ibanez-diego/proyecto-mecatronica-ibanez/Media/fotos/12.jpg

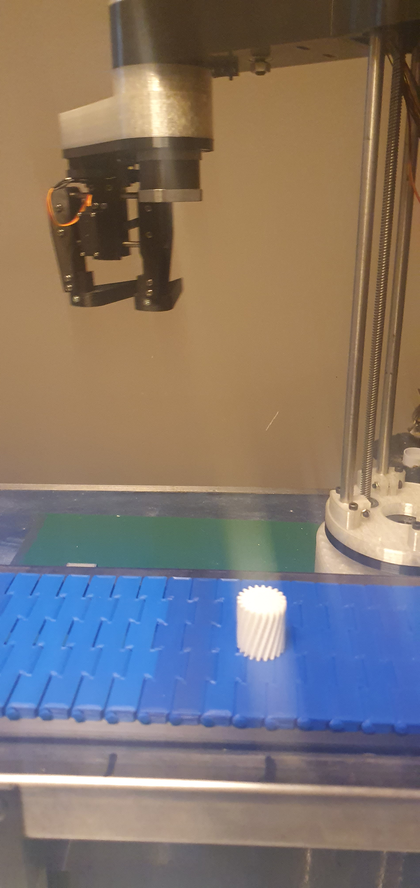
Media/fotos/12.jpg
