ibanez-diego/proyecto-mecatronica-ibanez/Media/fotos/4.jpg

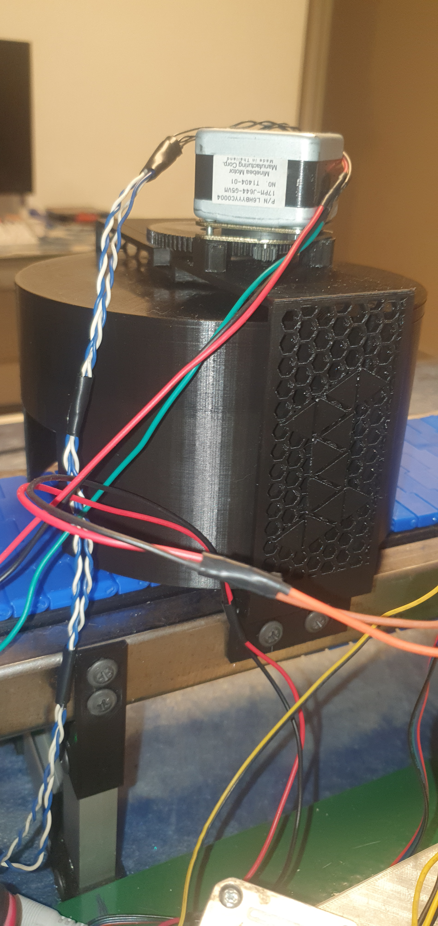
Media/fotos/4.jpg
