ibanez-diego/proyecto-mecatronica-ibanez/Documentacion/Diagrama_Conexion.png

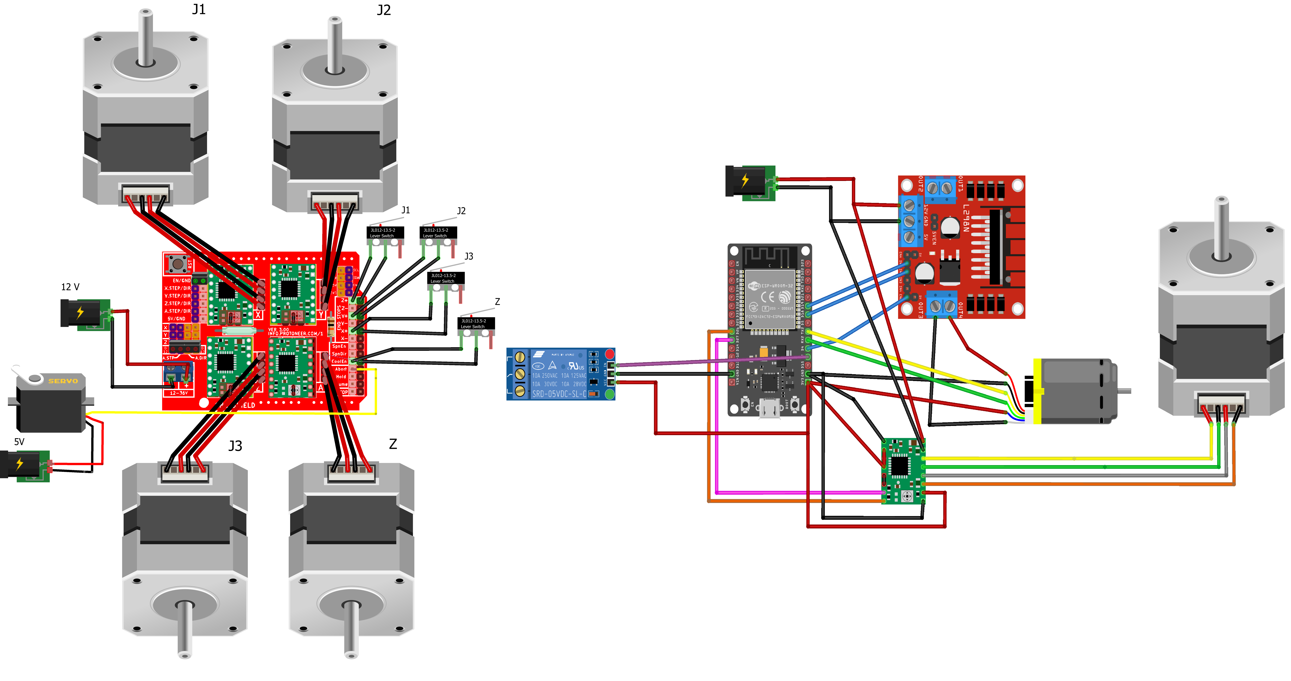
Documentacion/Diagrama_Conexion.png
