ibanez-diego/proyecto-mecatronica-ibanez/Documentacion/Diagrama_Flujo.png

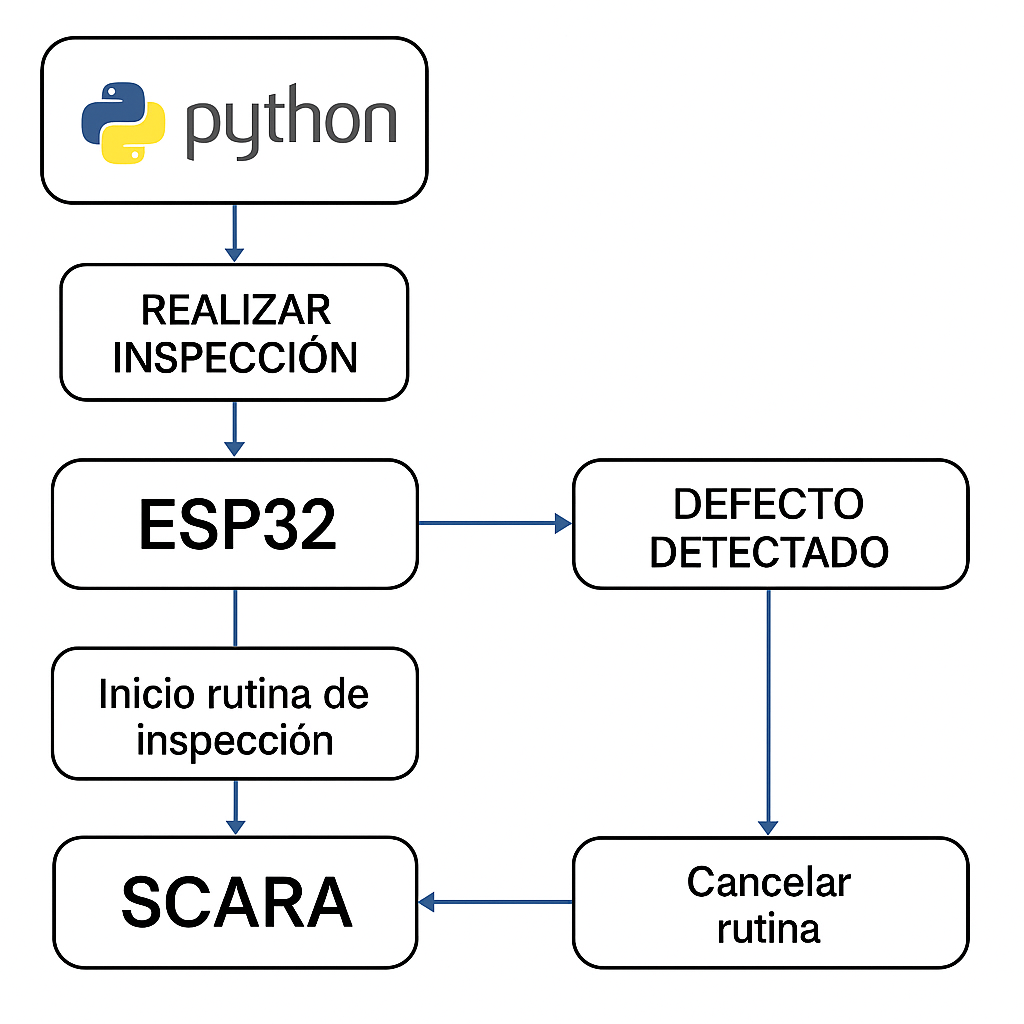
Documentacion/Diagrama_Flujo.png
