ibanez-diego/proyecto-mecatronica-ibanez/Media/fotos/1.jpg

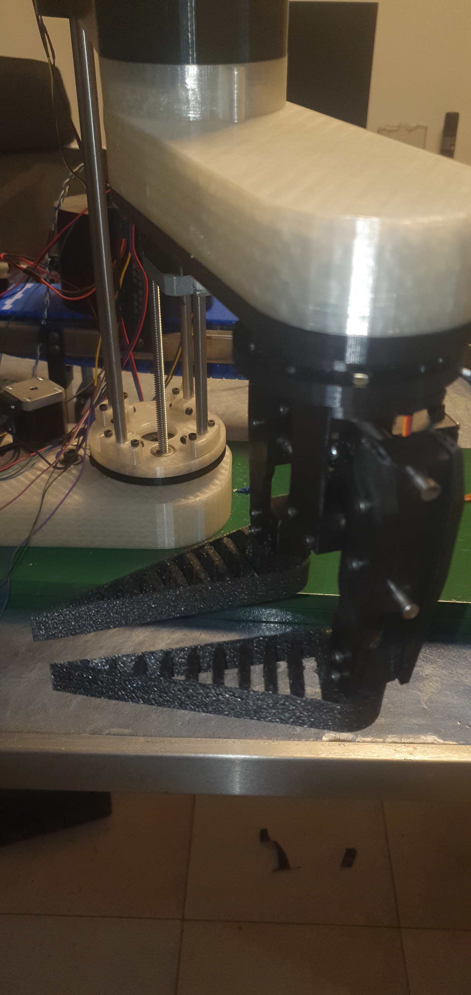
Media/fotos/1.jpg
