ibanez-diego/proyecto-mecatronica-ibanez/Media/fotos/2.jpg

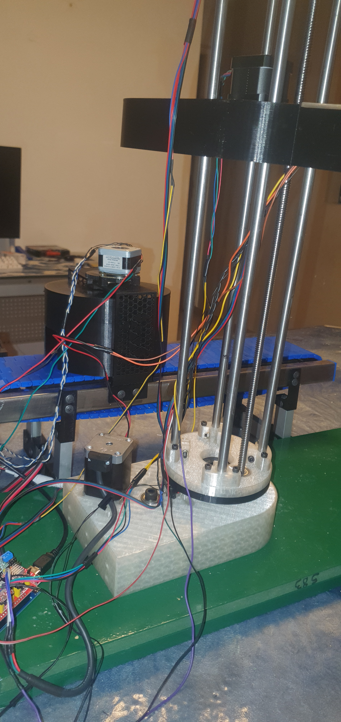
Media/fotos/2.jpg
