ibanez-diego/proyecto-mecatronica-ibanez/Media/fotos/3.jpg

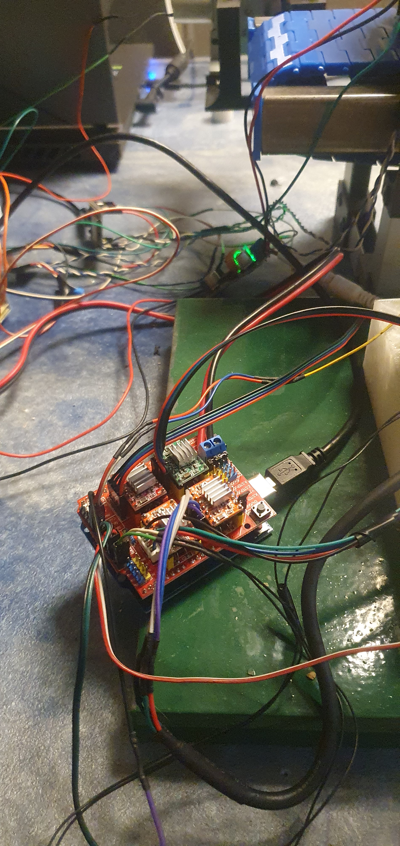
Media/fotos/3.jpg
