ibanez-diego/proyecto-mecatronica-ibanez/Media/fotos/5.jpg

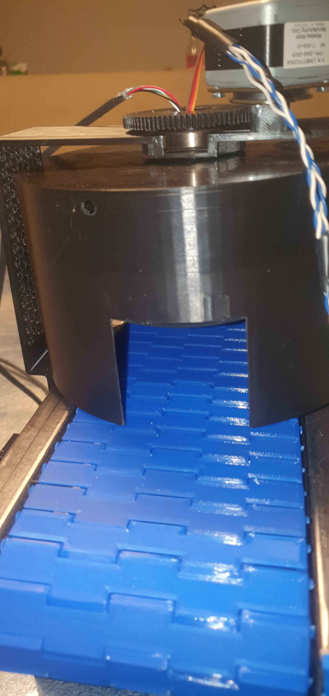
Media/fotos/5.jpg
