ibanez-diego/proyecto-mecatronica-ibanez/Media/fotos/6.jpg

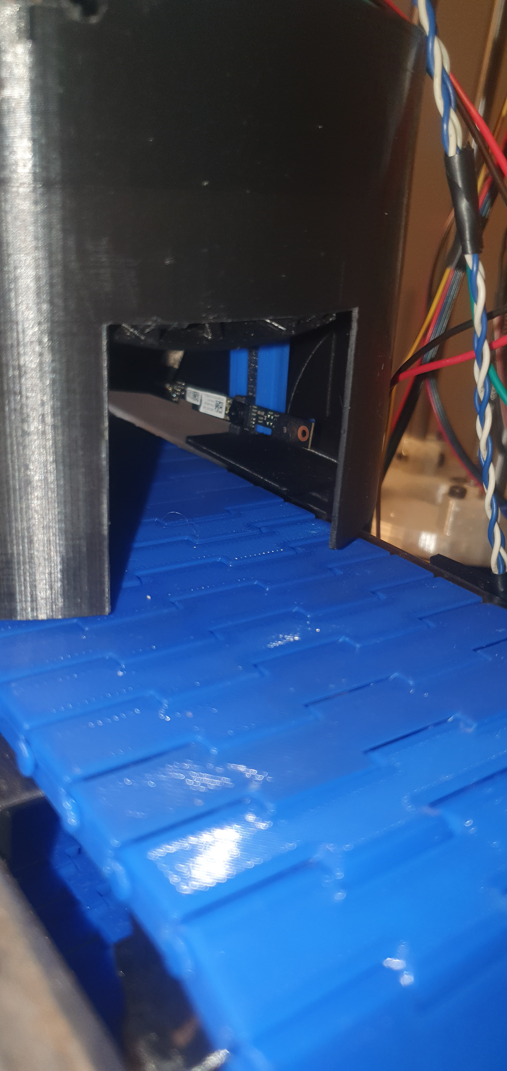
Media/fotos/6.jpg
