ibanez-diego/proyecto-mecatronica-ibanez/Media/fotos/7.jpg

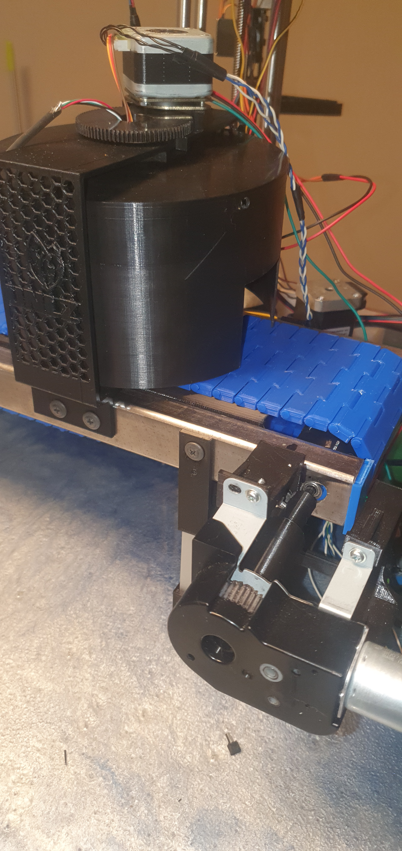
Media/fotos/7.jpg
