ibanez-diego/proyecto-mecatronica-ibanez/Media/fotos/8.jpg

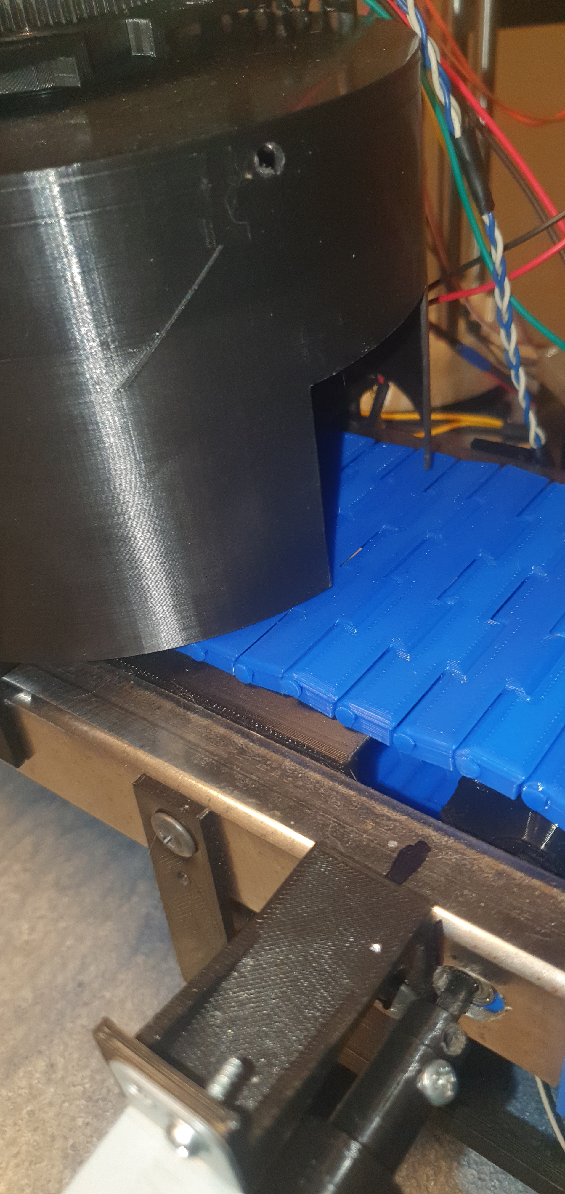
Media/fotos/8.jpg
