ibanez-diego/proyecto-mecatronica-ibanez/Media/fotos/9.jpg

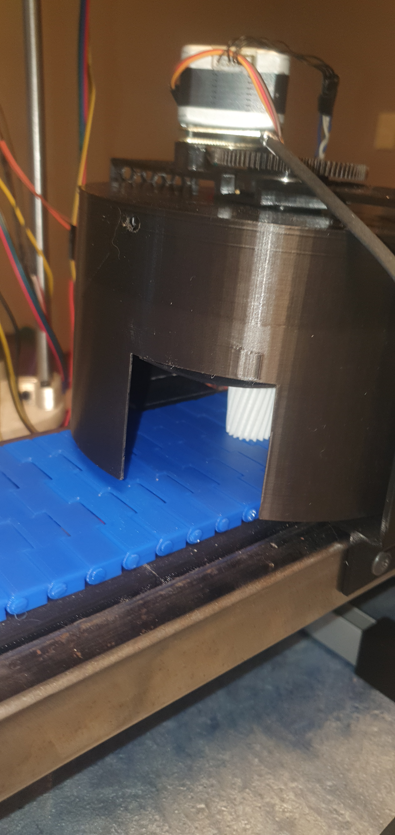
Media/fotos/9.jpg
