ibanez-diego/proyecto-mecatronica-ibanez/Media/fotos/10.jpg

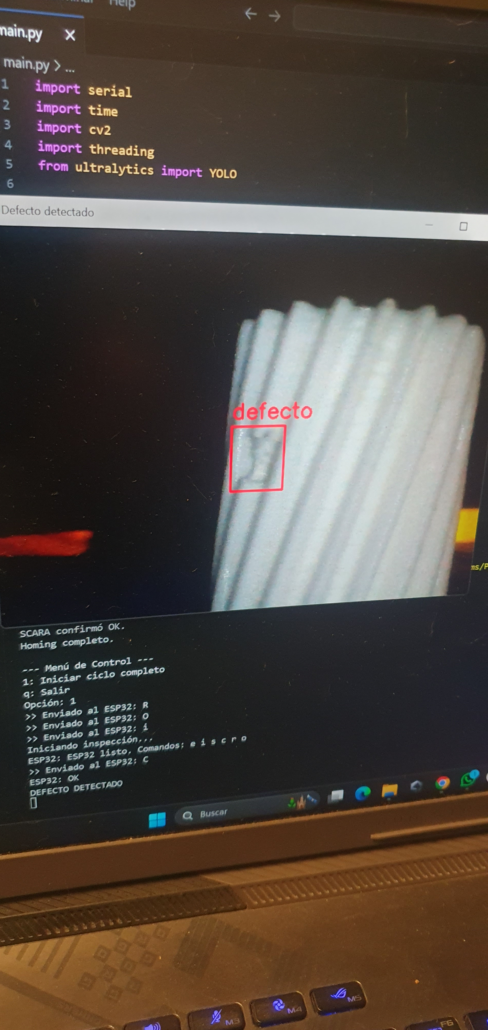
Media/fotos/10.jpg
