ibanez-diego/proyecto-mecatronica-ibanez/Media/fotos/11.jpg

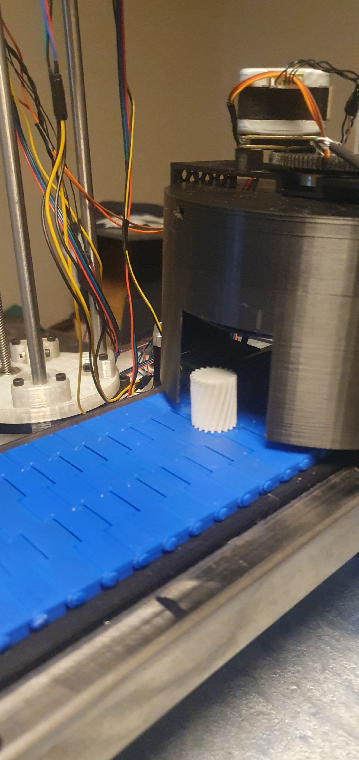
Media/fotos/11.jpg
