ibanez-diego/proyecto-mecatronica-ibanez/Media/fotos/13.jpg

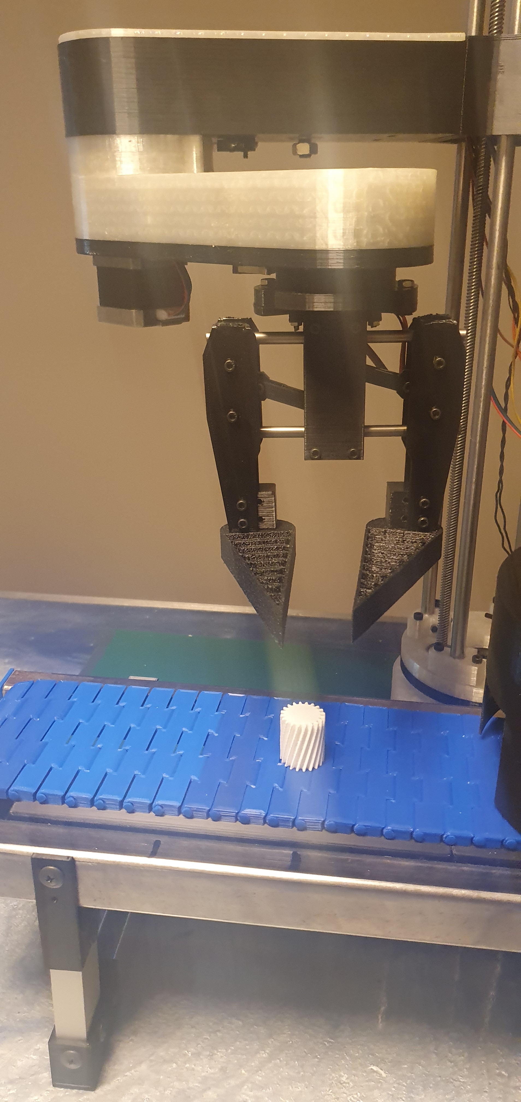
Media/fotos/13.jpg
