ibanez-diego/proyecto-mecatronica-ibanez/Media/fotos/14.jpg

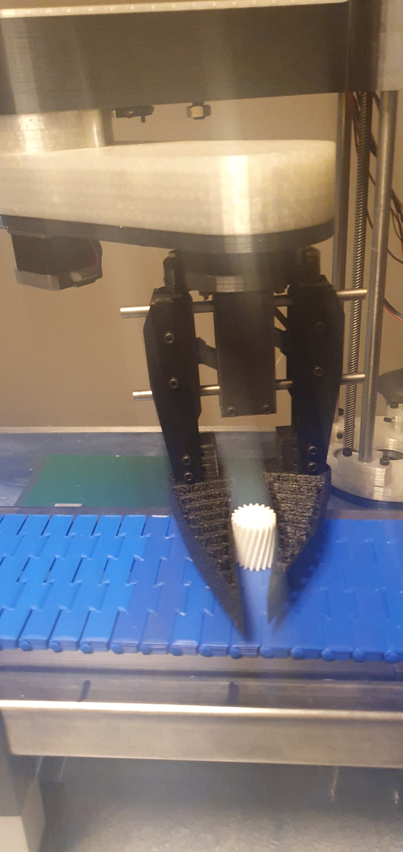
Media/fotos/14.jpg
