ibanez-diego/proyecto-mecatronica-ibanez/Media/fotos/15.jpg

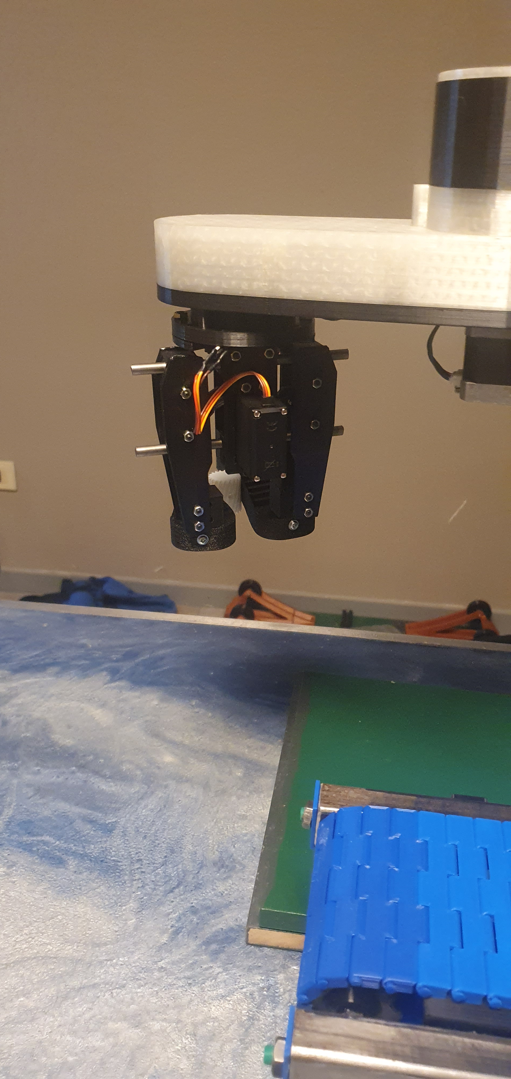
Media/fotos/15.jpg
