ibanez-diego/proyecto-mecatronica-ibanez/Documentacion/planos mecanicos/gripper.pdf

148.5 ¹²⁷.57 | 162.86 127.59 | Ø3.2 | Ø6 | Ø6.2 Ø4.1 | Ø3.6 | Ø1 5. Ø53 Ø12.5 | Ø30 Ø35 | Ø6 R3.6 | R3.1R3 R2R16
R3 | R28.5 R39 | R4.55 | R3.1 R3

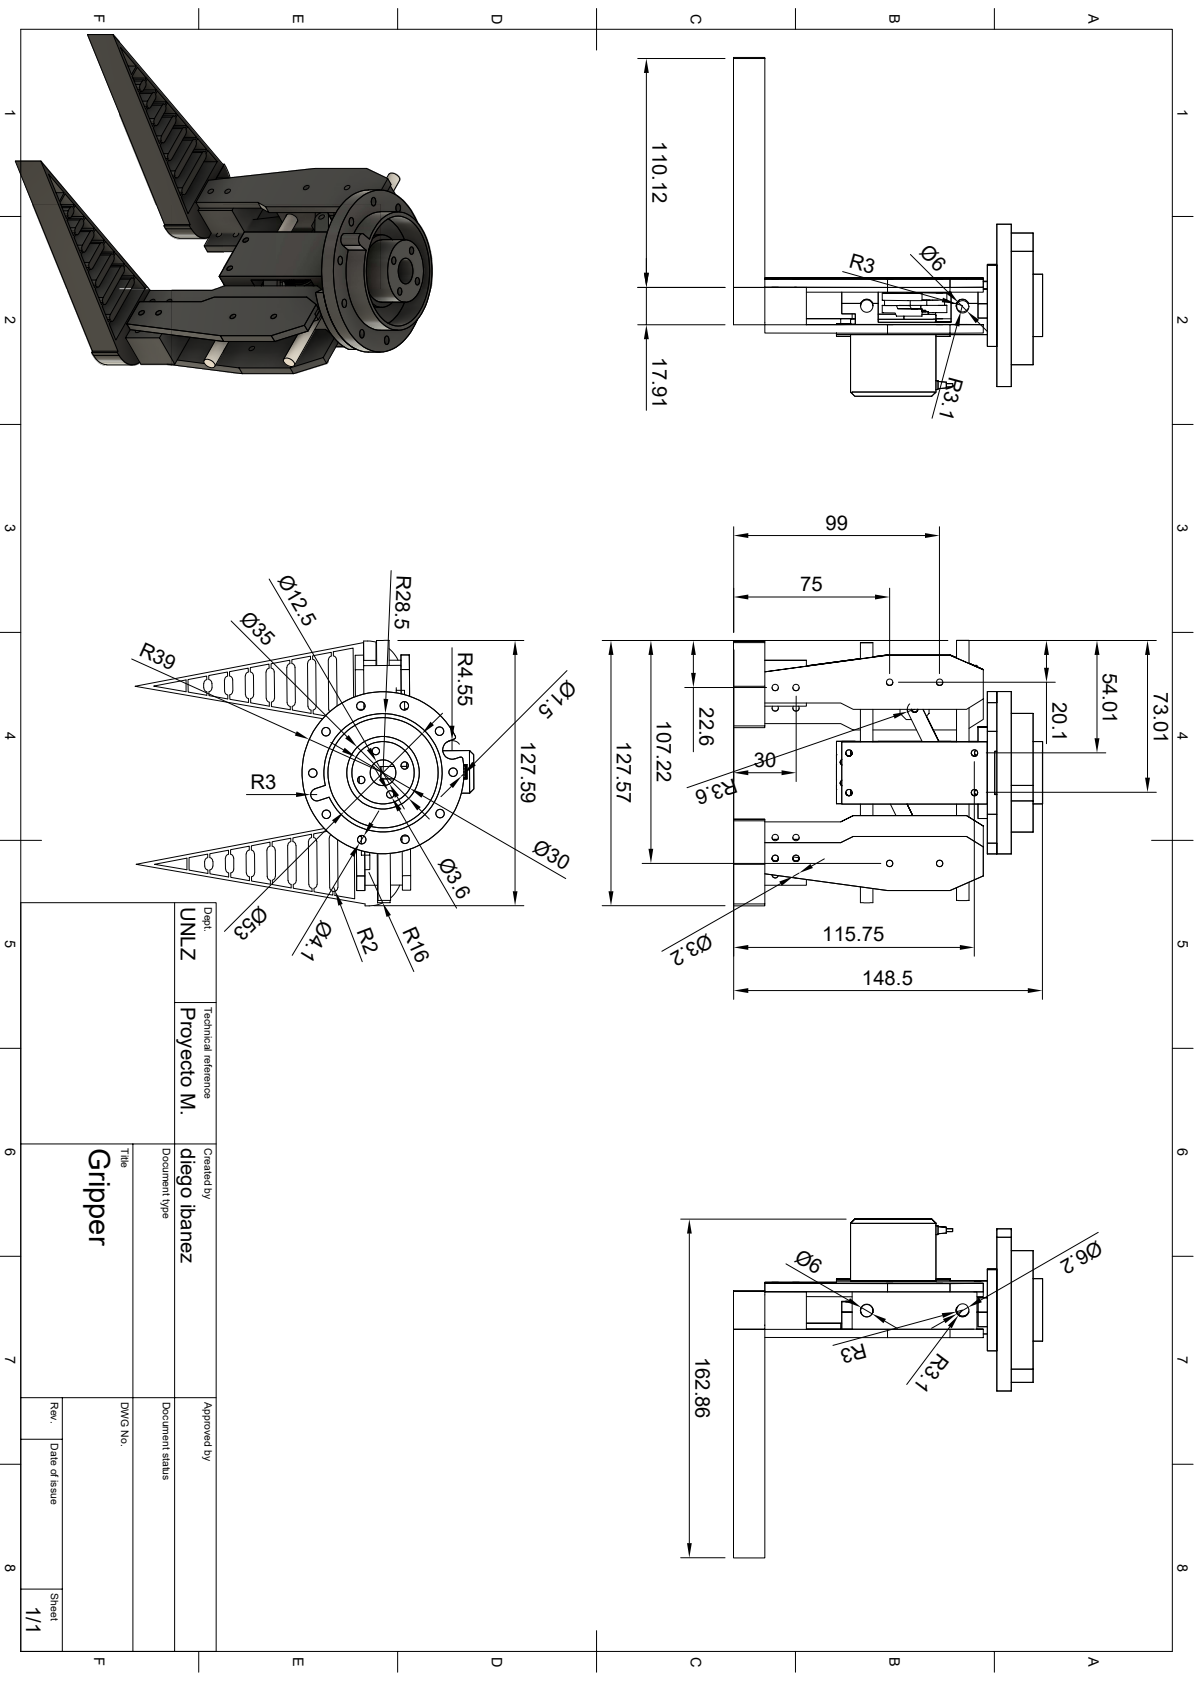
[picture p26: page 1]
115.75 ¹⁰⁷.22

1 A 2 3 4 5 6 7 8 1 2 3 4 5 6 7 8 FEDCB FEDCBA Dept. Technical reference Created by Approved by Title DWG No. Document type Document status Rev. Date of issue Sheet 1/1 Gripper diego ibanez Proyecto M. UNLZ
