ibanez-diego/proyecto-mecatronica-ibanez/Documentacion/planos mecanicos/guia_camara_soporte_servo.pdf

89.42 132.91 | 96.57
96.4 | Ø2.9 Ø5 Ø3 Ø7 Ø2.9 | R43.5 | R48.9 | R.56 R1 | R1.5 | R6.49 R5 R2.36 | R5.68 | R6.41

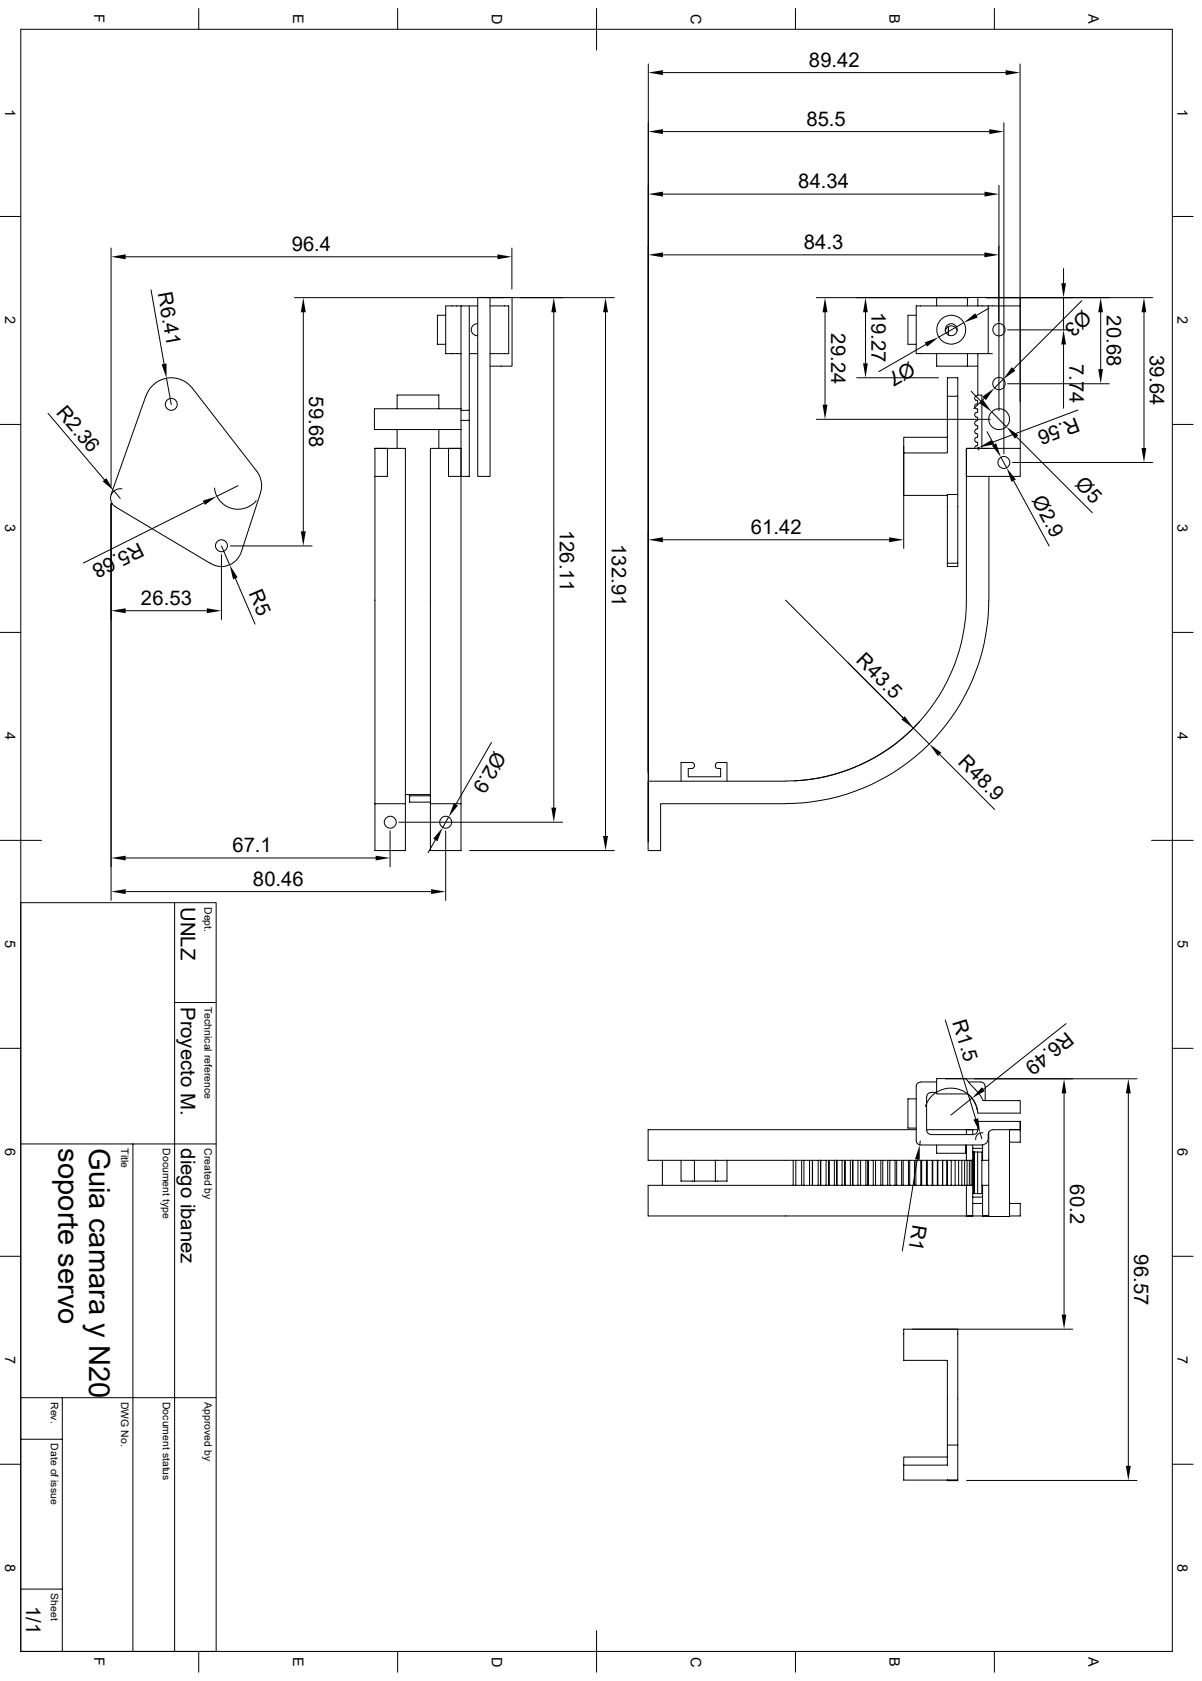
[picture p27: page 1]

1 A 2 3 4 5 6 7 8 1 2 3 4 5 6 7 8 FEDCB FEDCBA Dept. Technical reference Created by Approved by Title DWG No. Document type Document status Rev. Date of issue Sheet 1/1 soporte servo Guia camara y N20 diego ibanez Proyecto M. UNLZ
