ibanez-diego/proyecto-mecatronica-ibanez/Documentacion/planos mecanicos/J1.pdf

12.5 8

18 Ø9.95 Ø4.1Ø9.1 Ø15 Ø3.6 67.18 | 67.18

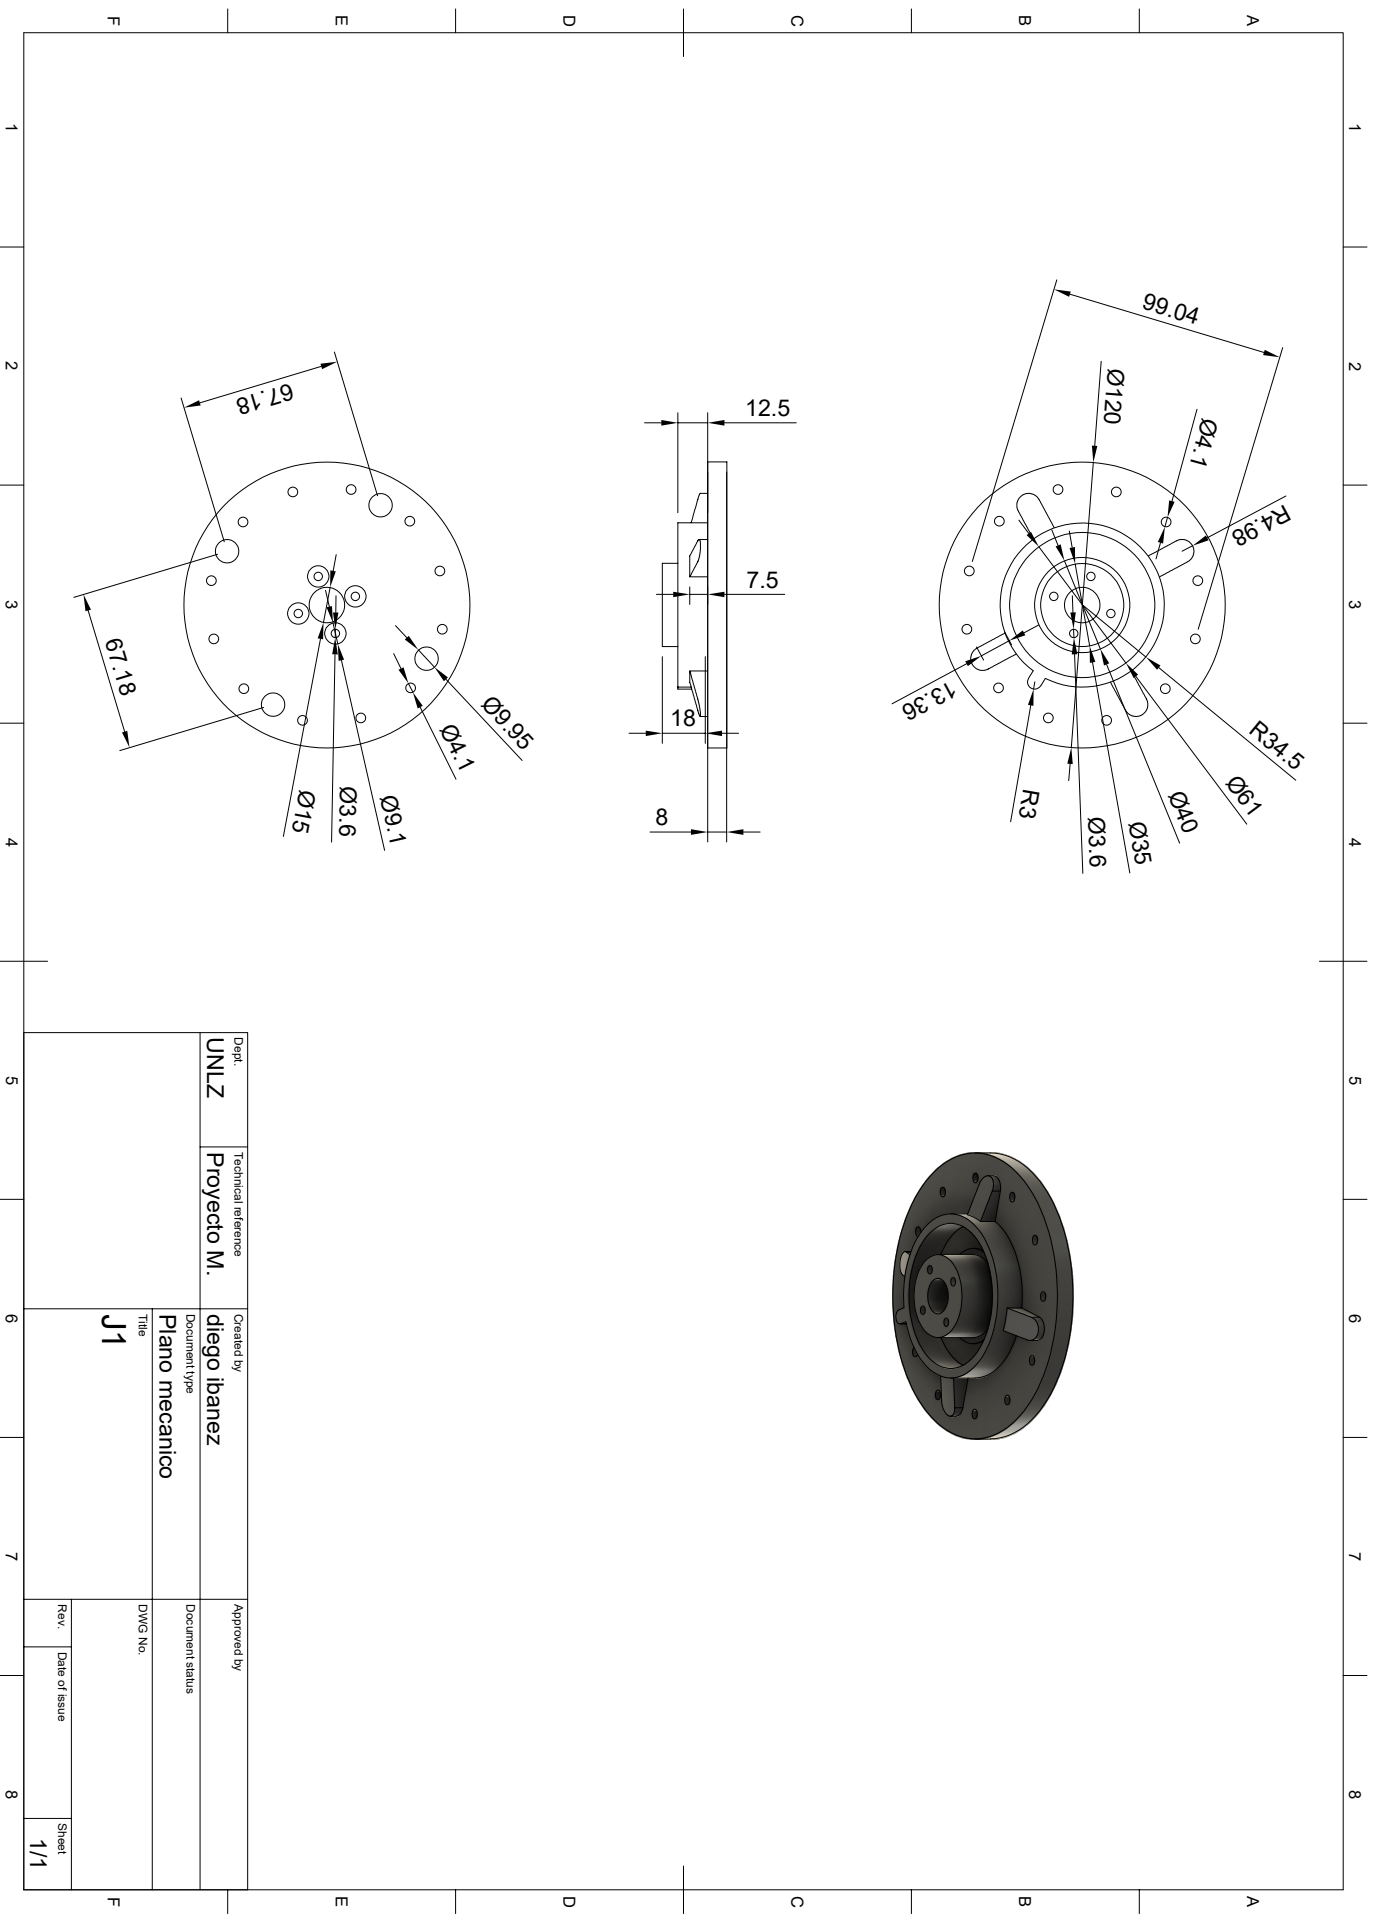
[picture p28: page 1]

1 A 2 3 4 5 6 7 8 1 2 3 4 5 6 7 8 FEDCB FEDCBA Dept. Technical reference Created by Approved by Title DWG No. Document type Document status Rev. Date of issue Sheet Plano mecanico 1/1 J1diego ibanez Proyecto M. UNLZ Ø4.1 R4.98 Ø120 R34.5 Ø61 Ø40 Ø3.6 Ø35 R3 99.04 13.36
