ibanez-diego/proyecto-mecatronica-ibanez/Documentacion/planos mecanicos/J2.pdf

18.5 Ø30 Ø53Ø35 R37 R39 | 4.16 ⁸.31 | Ø4.1

2.5

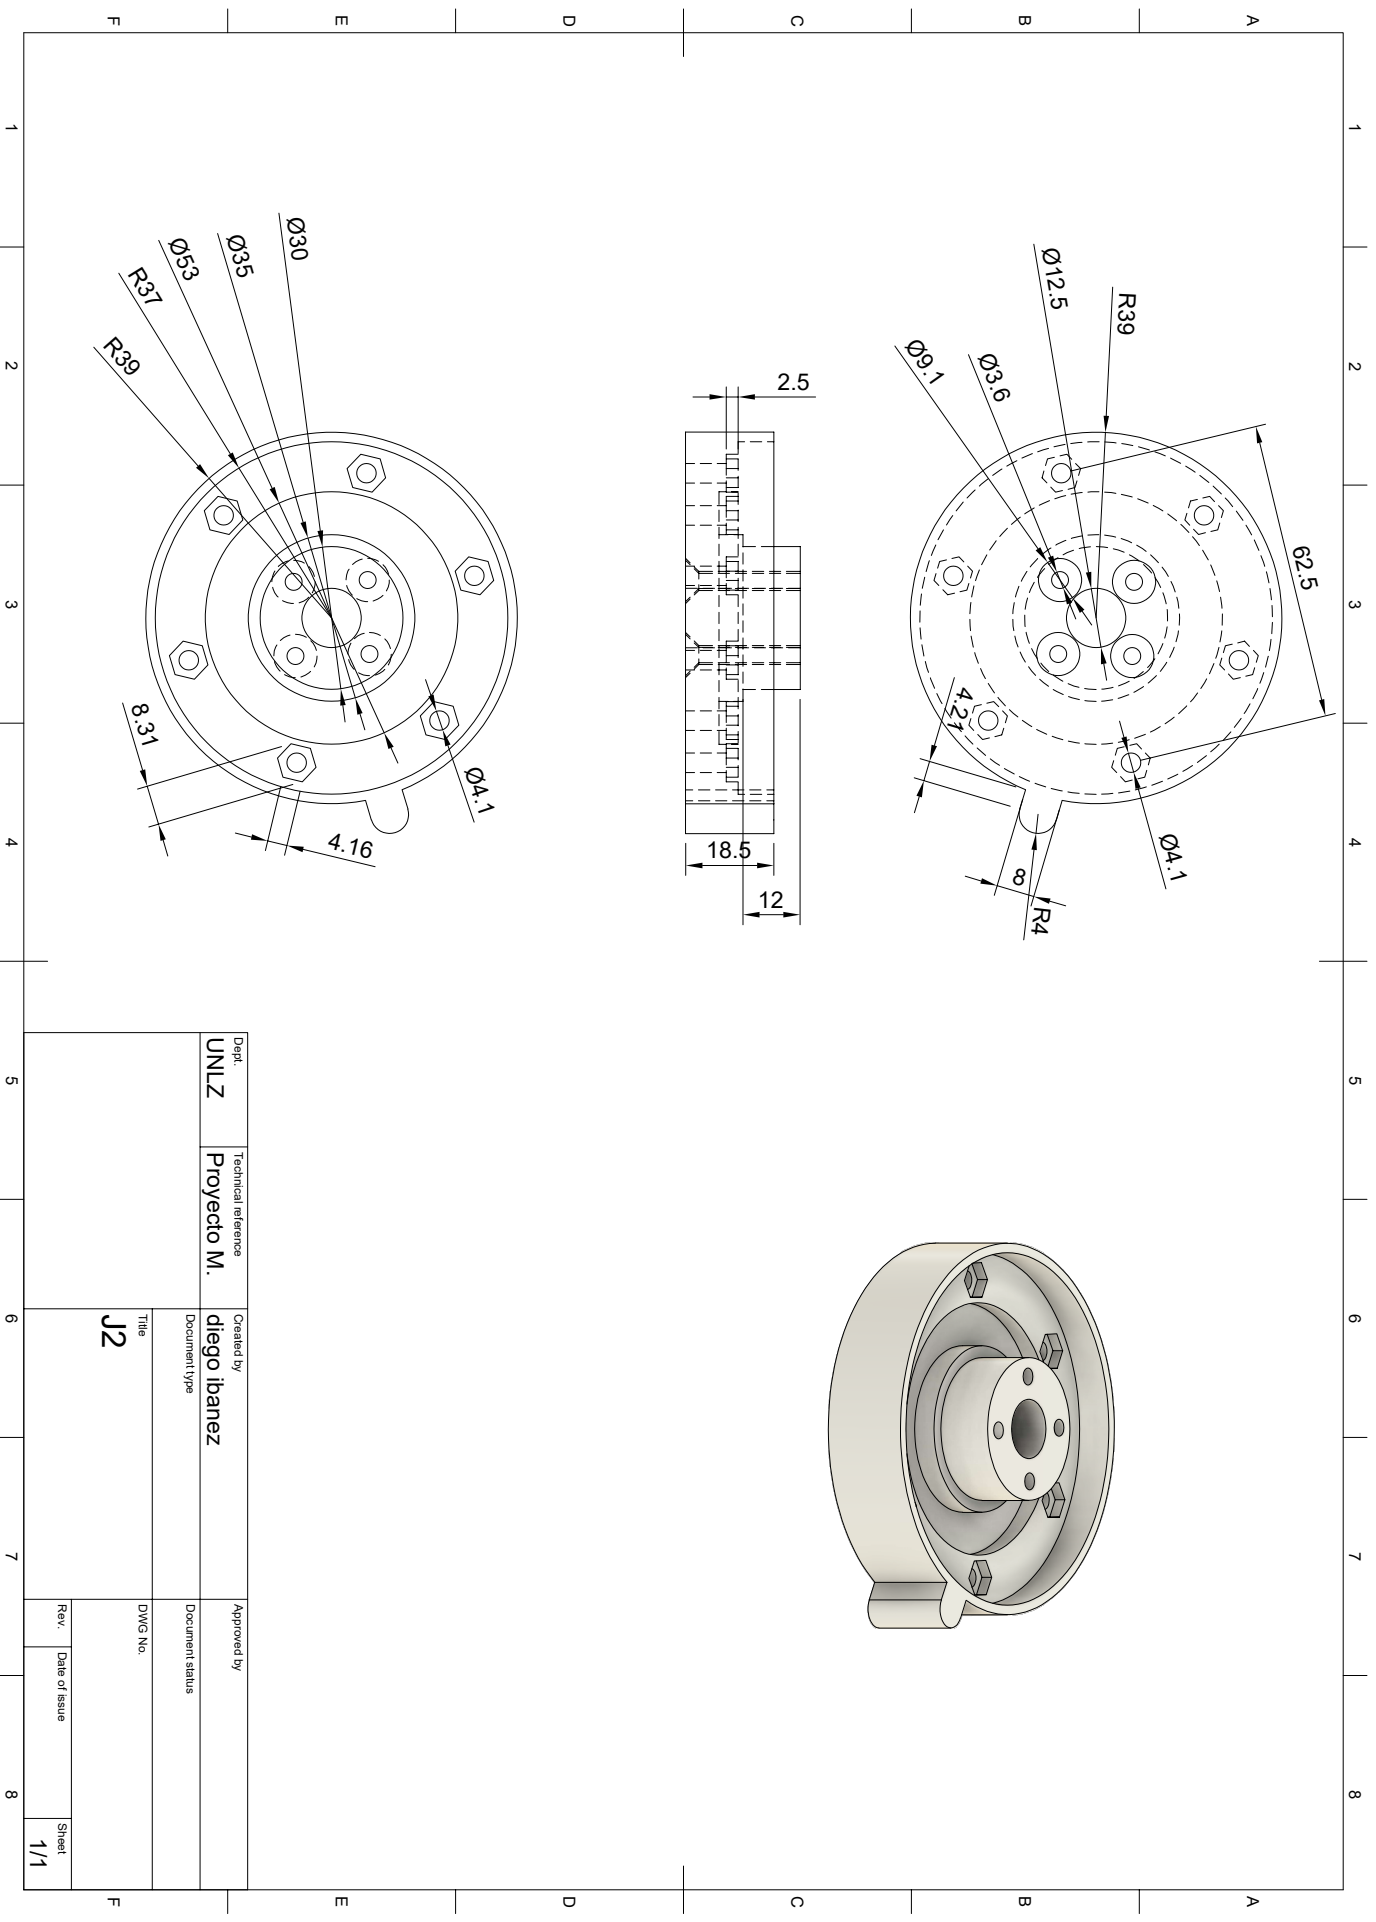
[picture p29: page 1]

1 A 2 3 4 5 6 7 8 1 2 3 4 5 6 7 8 FEDCB FEDCBA Dept. Technical reference Created by Approved by Title DWG No. Document type Document status Rev. Date of issue Sheet 1/1 J2diego ibanez Proyecto M. UNLZ Ø4.1R4 4.21 Ø9.1Ø3.6 62.5 R39 Ø12.5 8
