ibanez-diego/proyecto-mecatronica-ibanez/Documentacion/planos mecanicos/J3.pdf

10.5

14

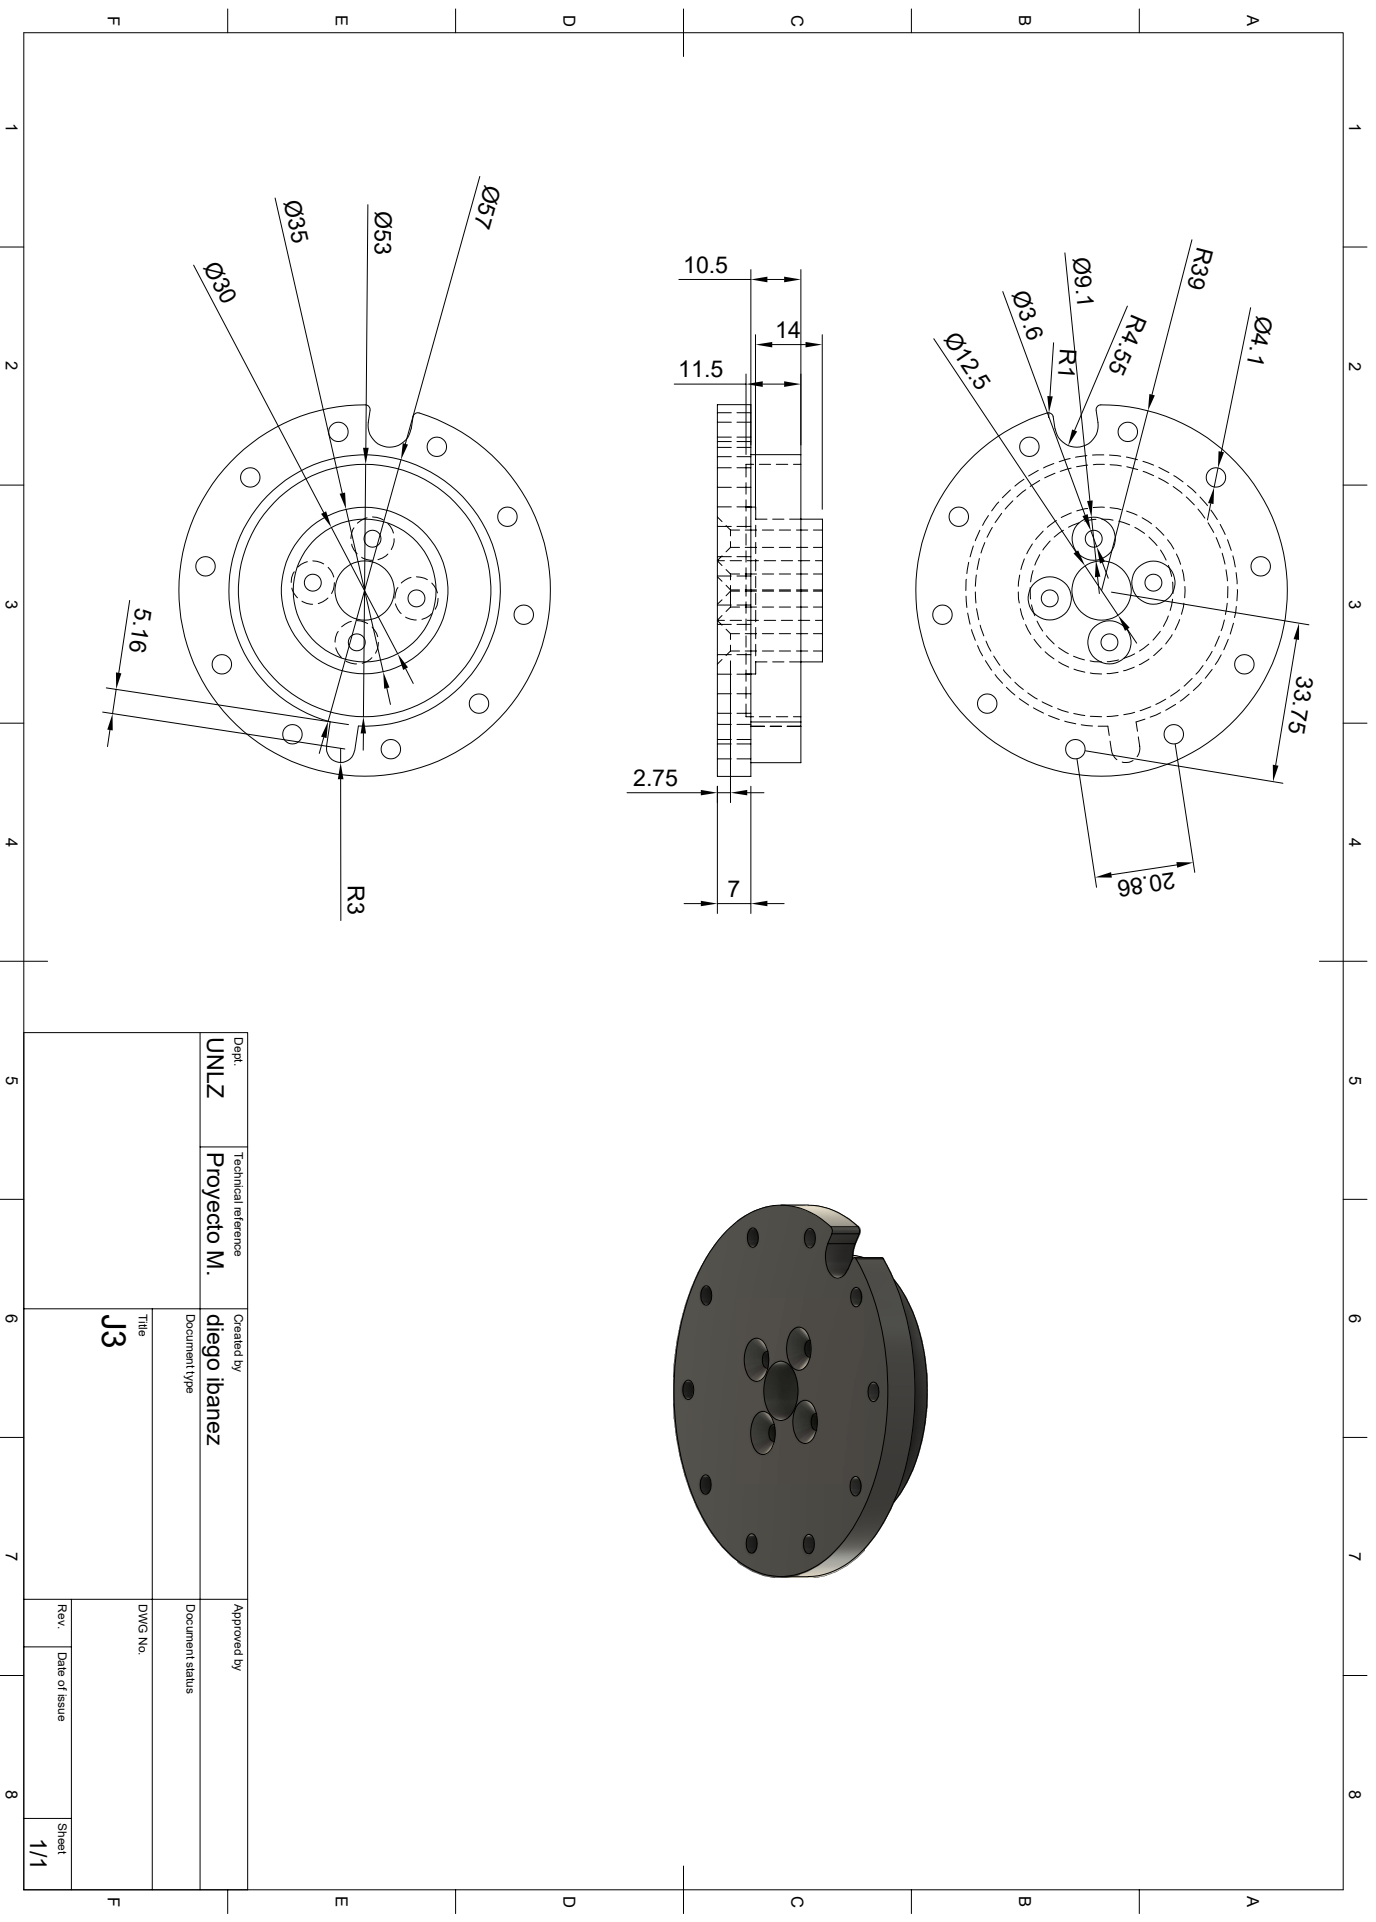
[picture p30: page 1]

1 A 2 3 4 5 6 7 8 1 2 3 4 5 6 7 8 FEDCB FEDCBA Dept. Technical reference Created by Approved by Title DWG No. Document type Document status Rev. Date of issue Sheet 1/1 J3diego ibanez Proyecto M. UNLZ R39 Ø4.1 Ø9.1Ø3.6 Ø12.5 R4.55R1 20.86 33.75
