ibanez-diego/proyecto-mecatronica-ibanez/Documentacion/planos mecanicos/Recductor_J1.pdf

72.49 | Ø3.6 Ø3.6 | Ø15 Ø71.92 Ø15 Ø35 Ø40 Ø62 | Ø8 Ø52.82 Ø15.9 Ø52.82Ø8 | Ø14.62R2.5 R2.5 67.77
42.61 39.44

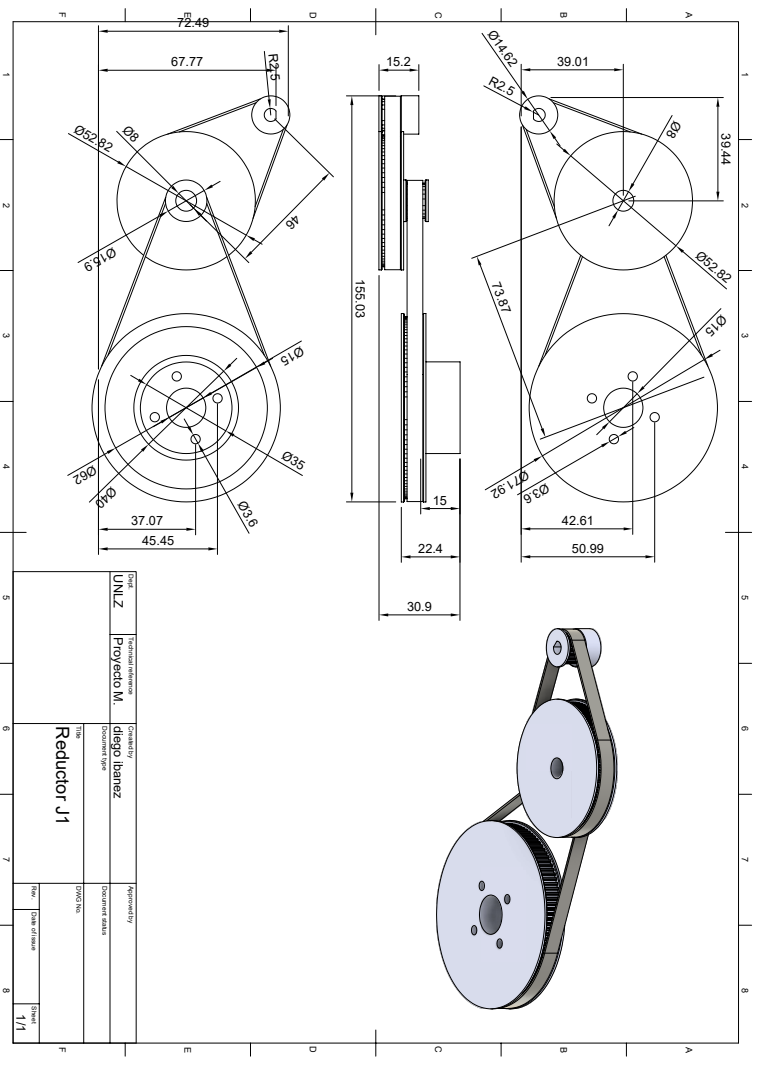
[picture p31: page 1]

1 A 2 3 4 5 6 7 8 1 2 3 4 5 6 7 8 FEDCB FEDCBA Dept. Technical reference Created by Approved by Title DWG No. Document type Document status Rev. Date of issue Sheet 1/1 Reductor J1 diego ibanez Proyecto M. UNLZ 155.03
