ibanez-diego/proyecto-mecatronica-ibanez/Documentacion/planos mecanicos/Recductor_J2.pdf

36.2 | 105.99 | Ø3 6. Ø3.6 | Ø12.5 | Ø30 Ø35 Ø53 Ø60.46Ø12.5 | Ø17.33 Ø8 Ø53.62 Ø8 | Ø14.62 R2.5 R2.5 146.76 90

42.57 25.88

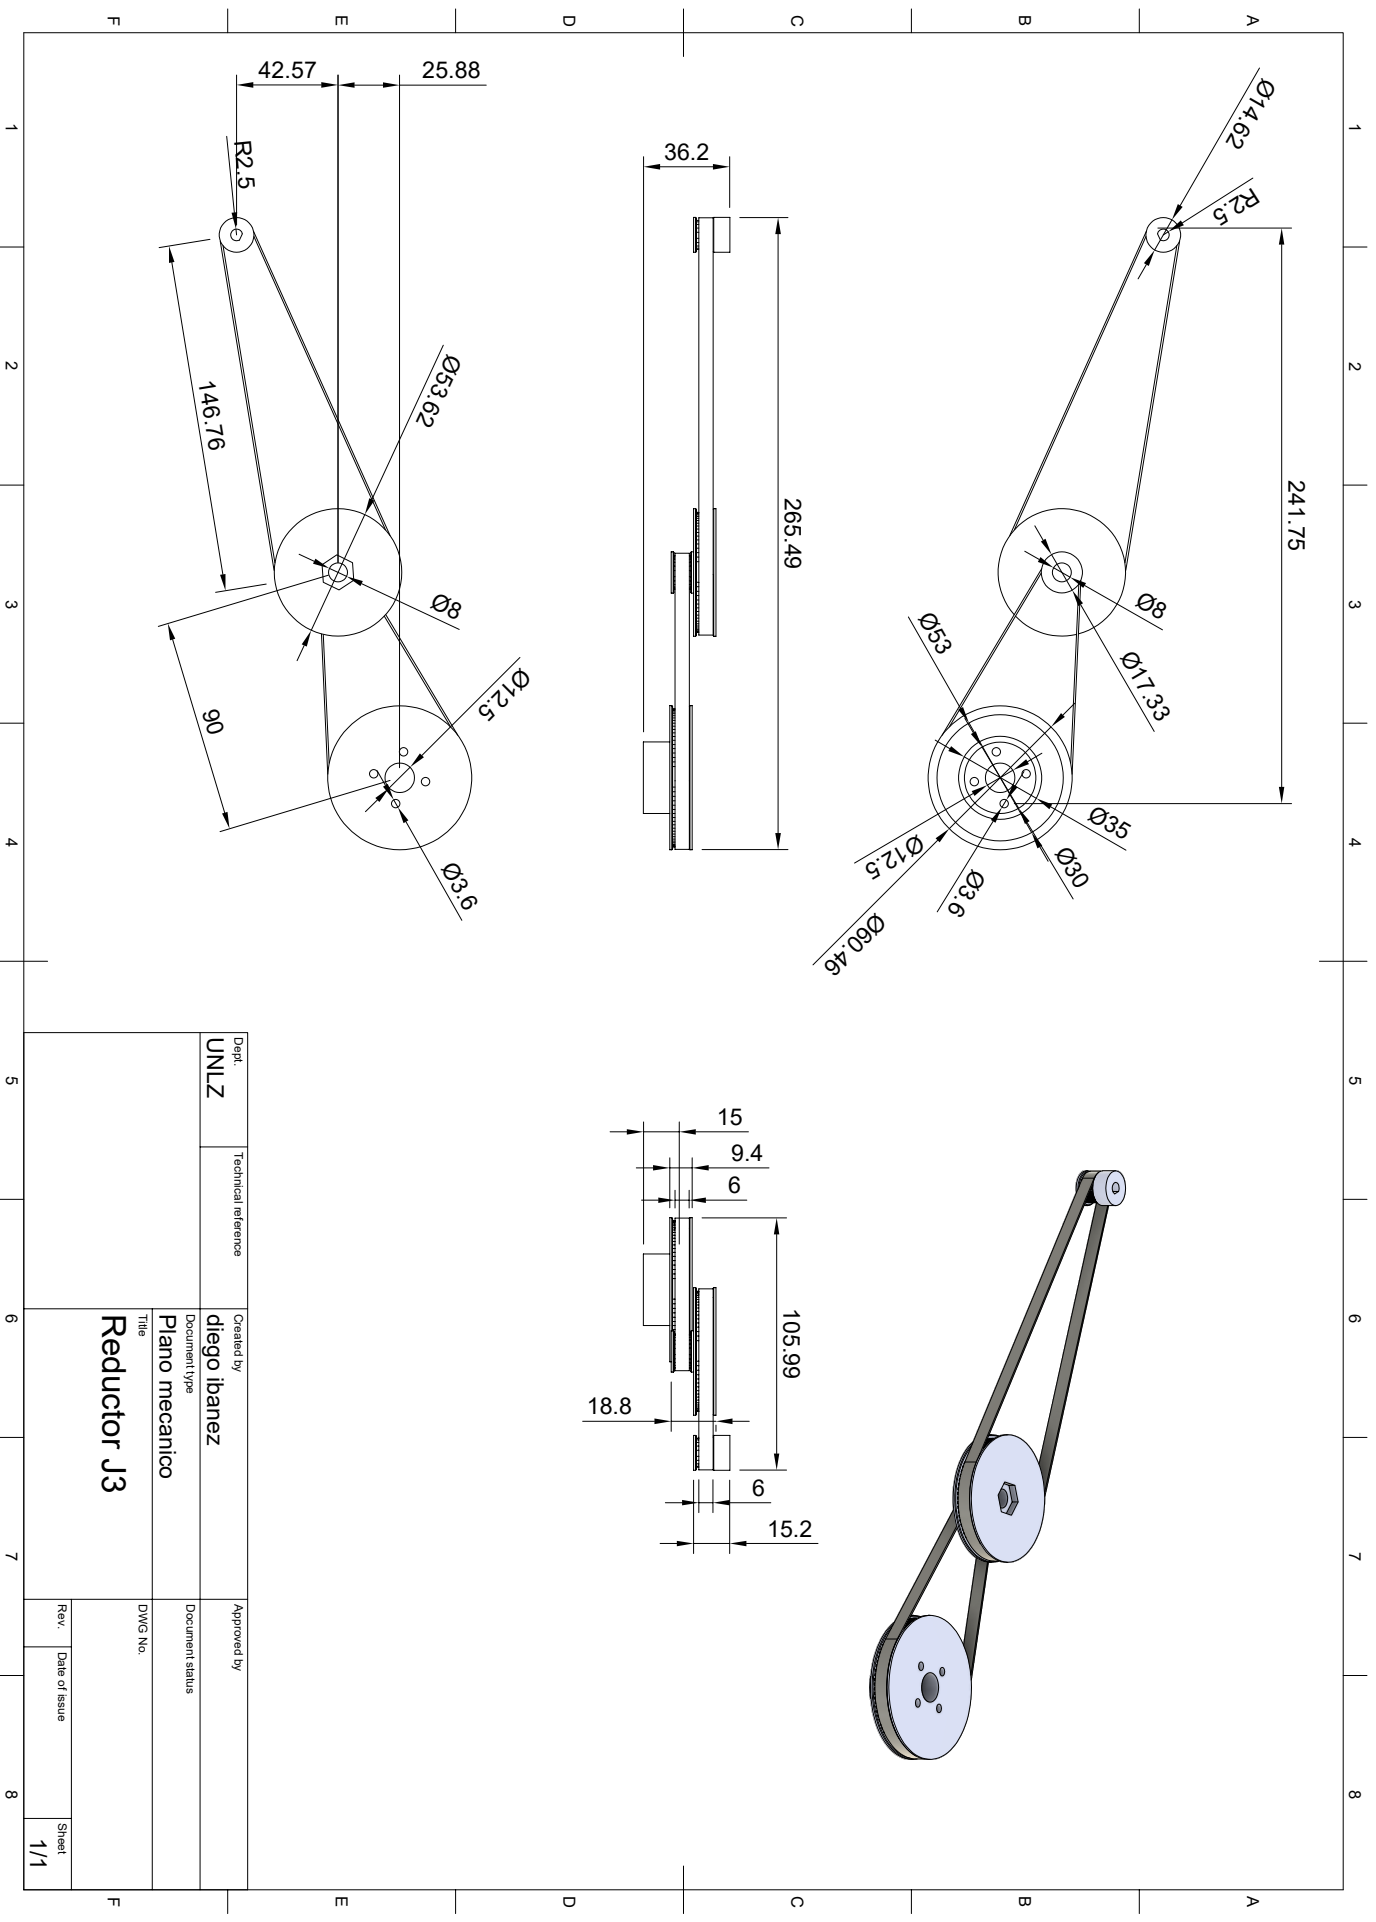
[picture p32: page 1]

1 A 2 3 4 5 6 7 8 1 2 3 4 5 6 7 8 FEDCB FEDCBA Dept. Technical reference Created by Approved by Title DWG No. Document type Document status Rev. Date of issue Sheet Plano mecanico 1/1 Reductor J3 diego ibanez UNLZ 241.75 265.49
