ibanez-diego/proyecto-mecatronica-ibanez/Documentacion/planos mecanicos/Recductor_J3.pdf

40.37 | 6 | 12.2 Ø30 | Ø14.62

# 9.4 ²

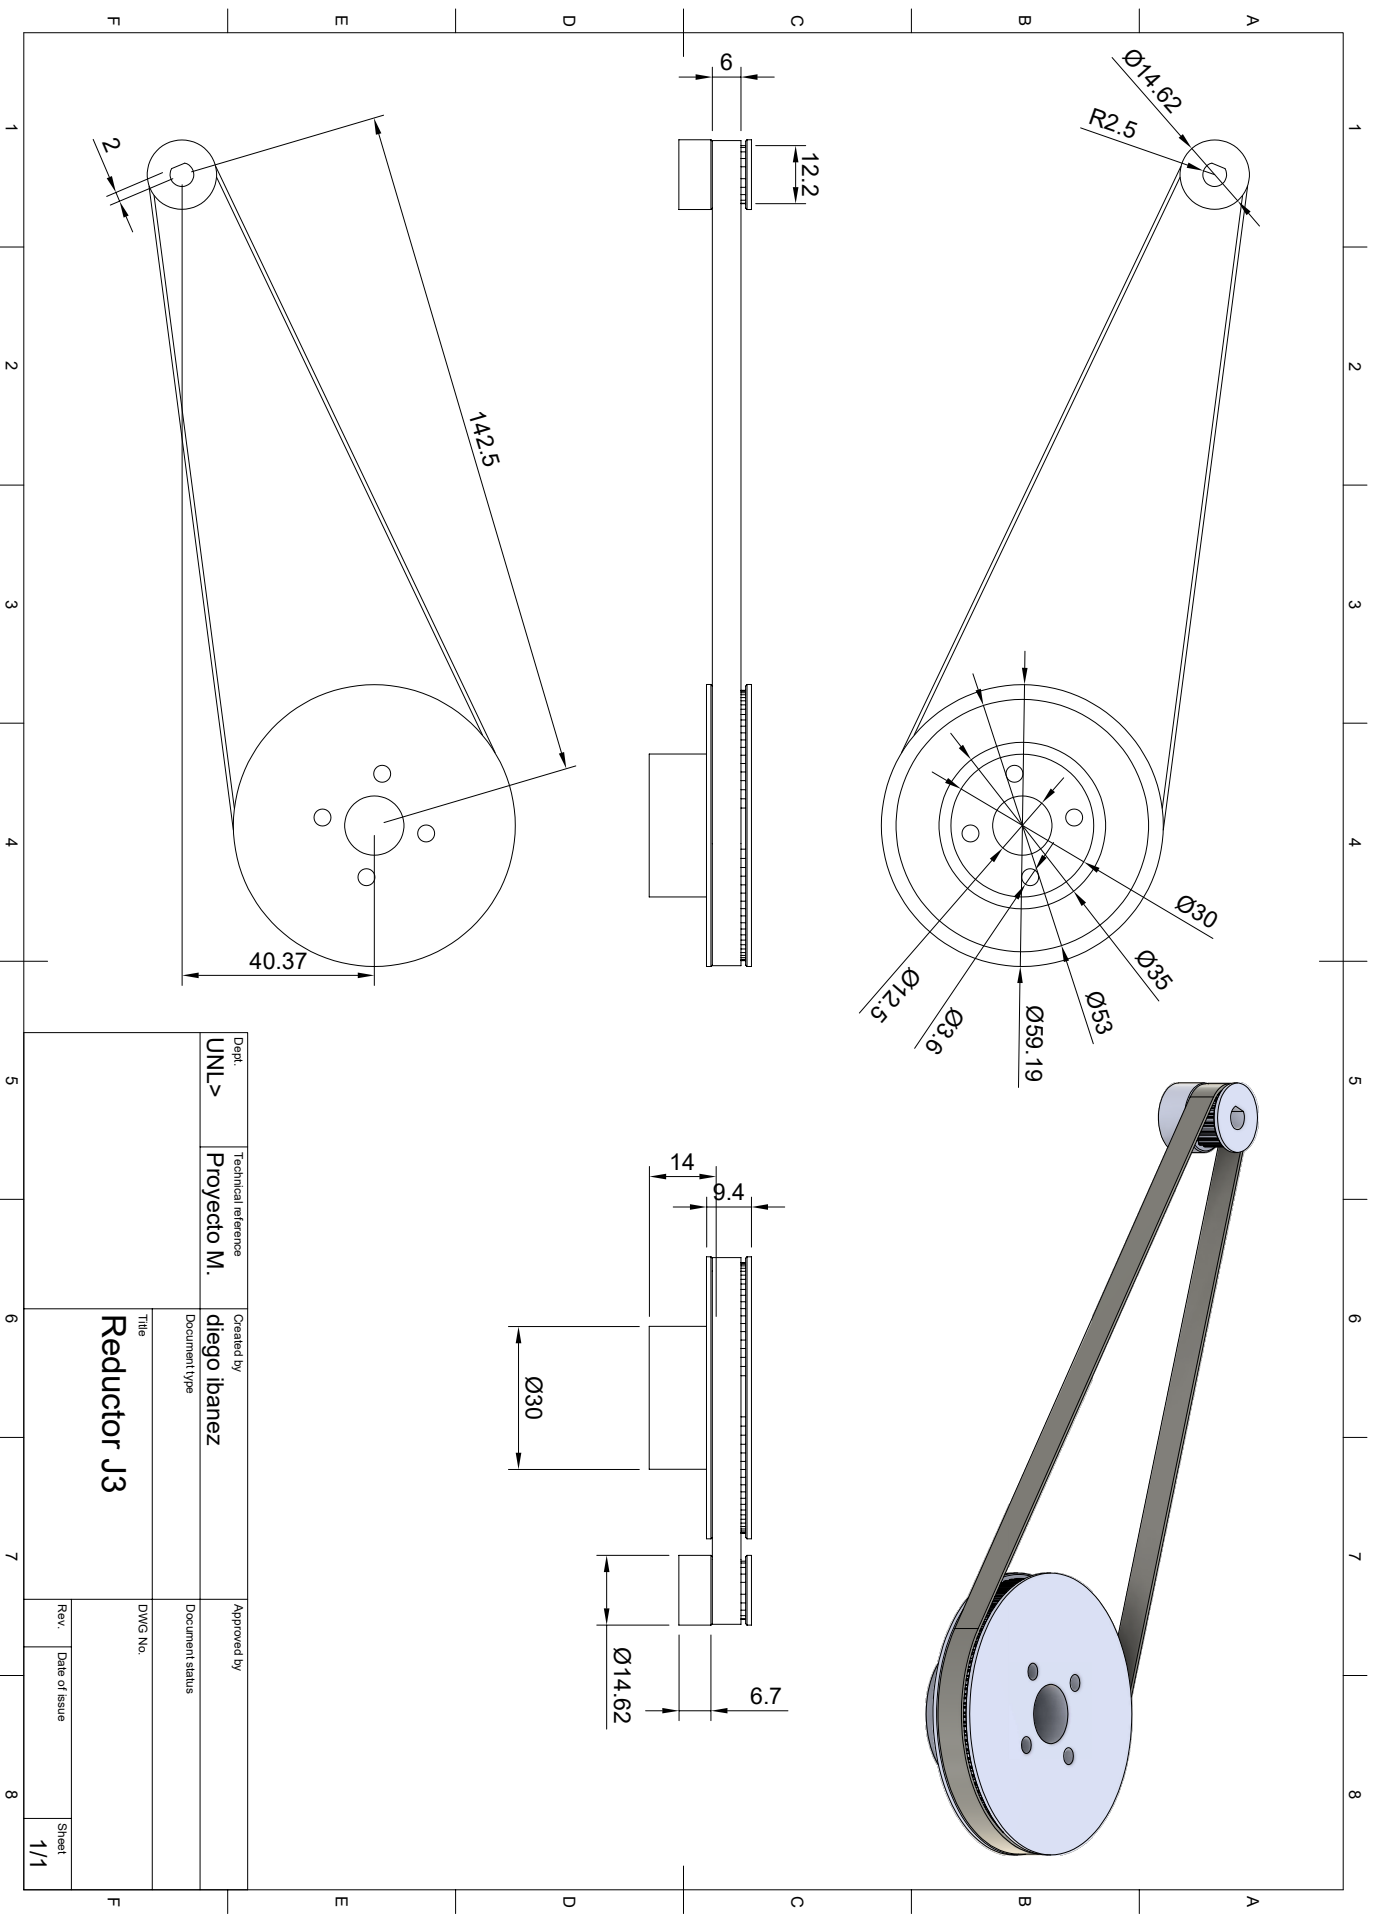
[picture p33: page 1]

1 A 2 3 4 5 6 7 8 1 2 3 4 5 6 7 8 FEDCB FEDCBA Dept. Technical reference Created by Approved by Title DWG No. Document type Document status Rev. Date of issue Sheet 1/1 Reductor J3 diego ibanez Proyecto M. UNL> Ø59.19 Ø53 Ø35 Ø30 Ø3.6 Ø12.5 R2.5 Ø14.62 142.5
