ibanez-diego/proyecto-mecatronica-ibanez/Documentacion/planos mecanicos/brazo_1.pdf

85 123.41 | Ø3.6 Ø3.6 | Ø12.5 | Ø30 | Ø53 Ø60.46 | Ø35 Ø12.5 Ø60.46 | Ø3.2 Ø3.2 | Ø8 Ø22 | Ø53.62 Ø14 Ø19
40 | 41.17 | R51.26 | 67.18

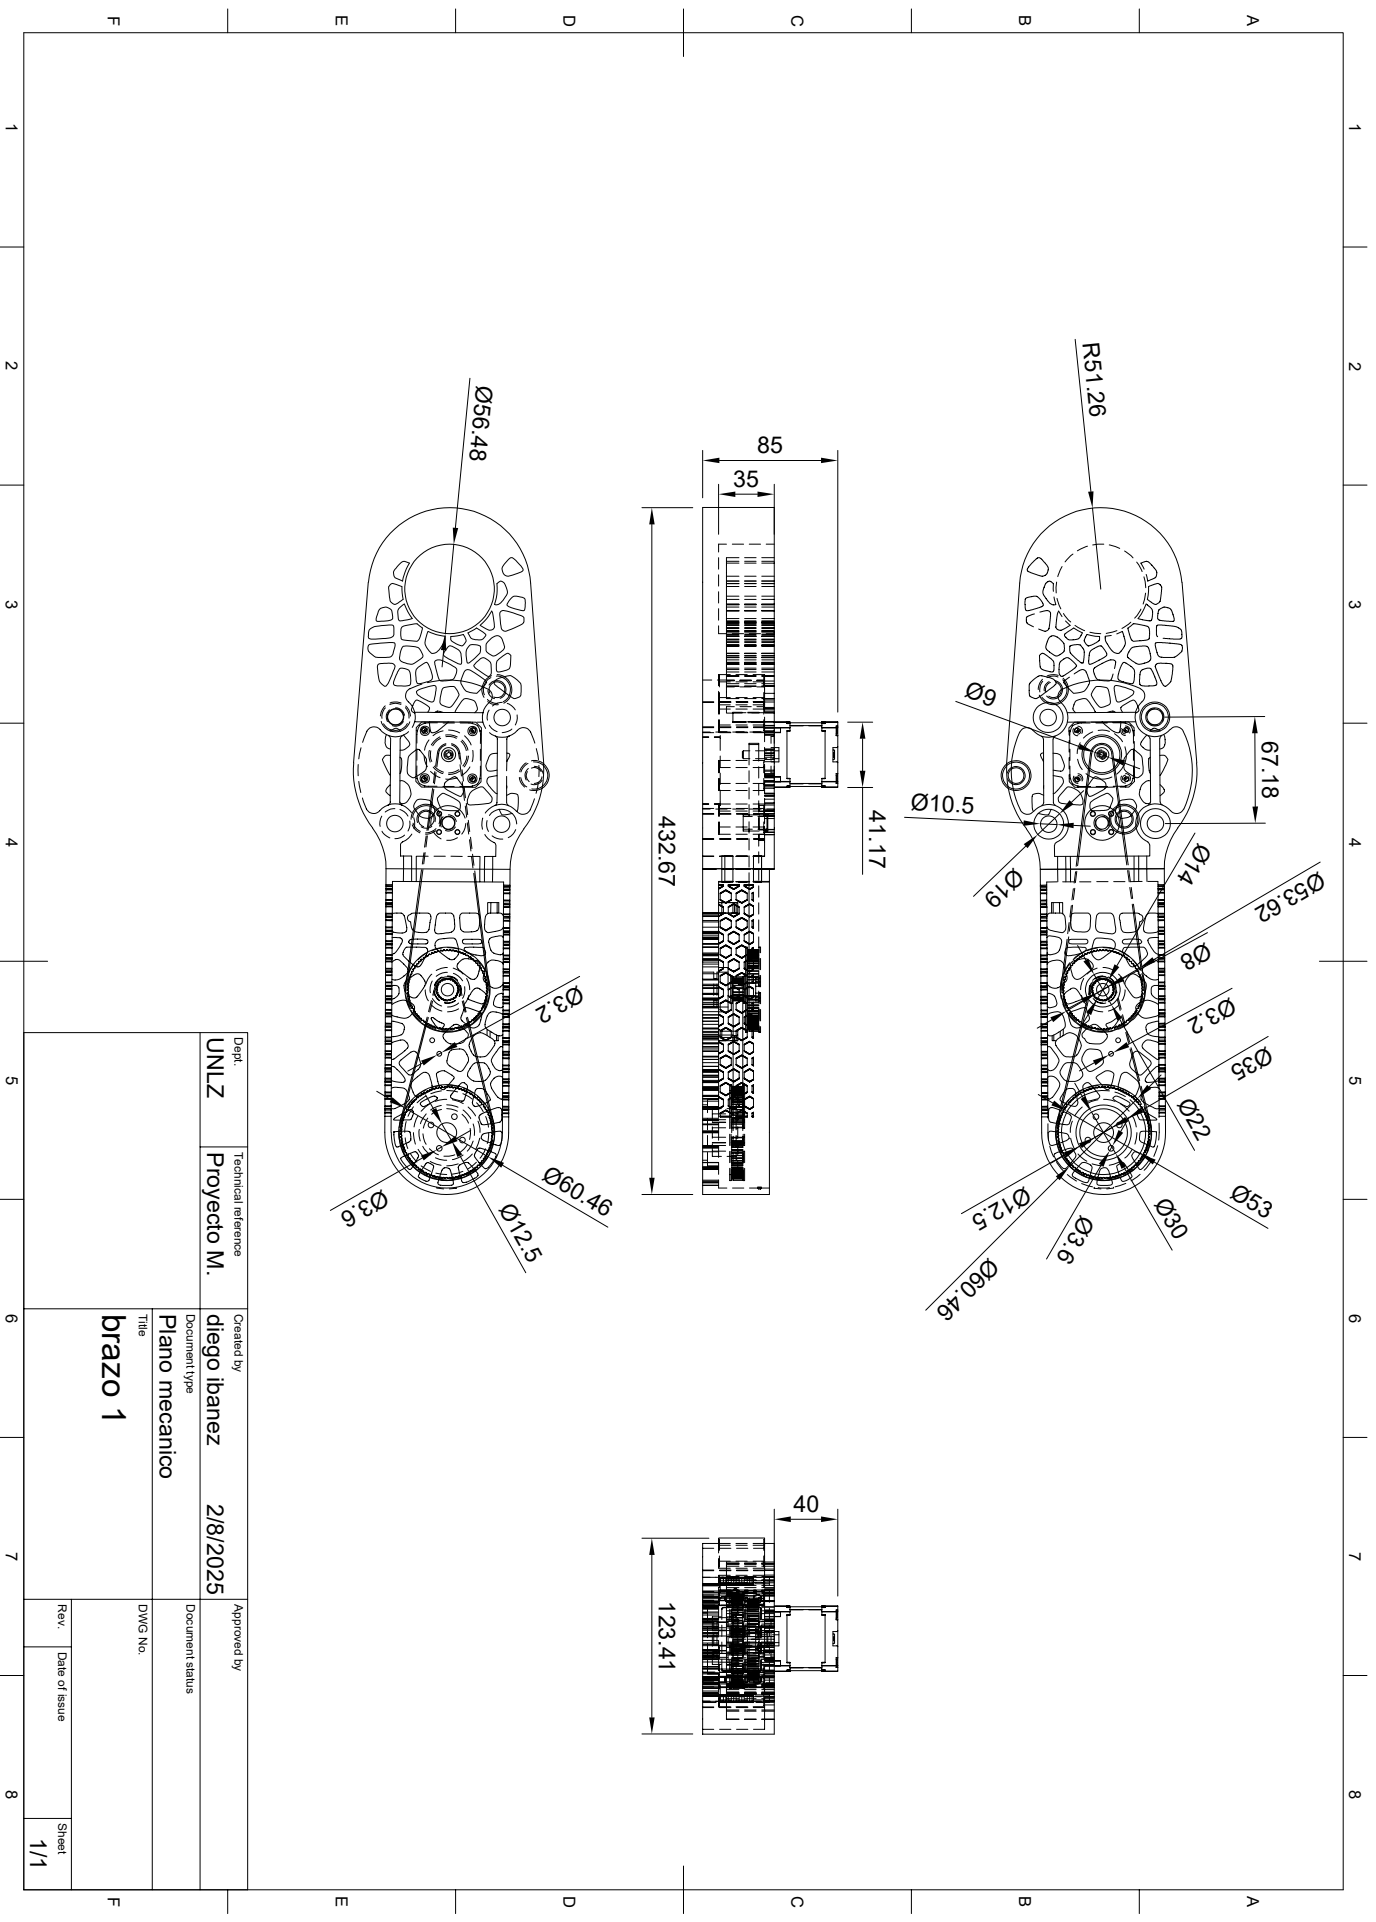
[picture p34: page 1]

1 A 2 3 4 5 6 7 8 1 2 3 4 5 6 7 8 FEDCB FEDCBA Dept. Technical reference Created by Approved by Title DWG No. Document type Document status Rev. Date of issue Sheet Plano mecanico 2/8/2025 1/1 brazo 1 diego ibanez Proyecto M. UNLZ 432.67
