ibanez-diego/proyecto-mecatronica-ibanez/Documentacion/planos mecanicos/cabina.pdf

90.24 Ø2.9 | Ø2.5 | Ø10 Ø18.33 Ø18.33 | R78.5 137.53

74.33 71.1

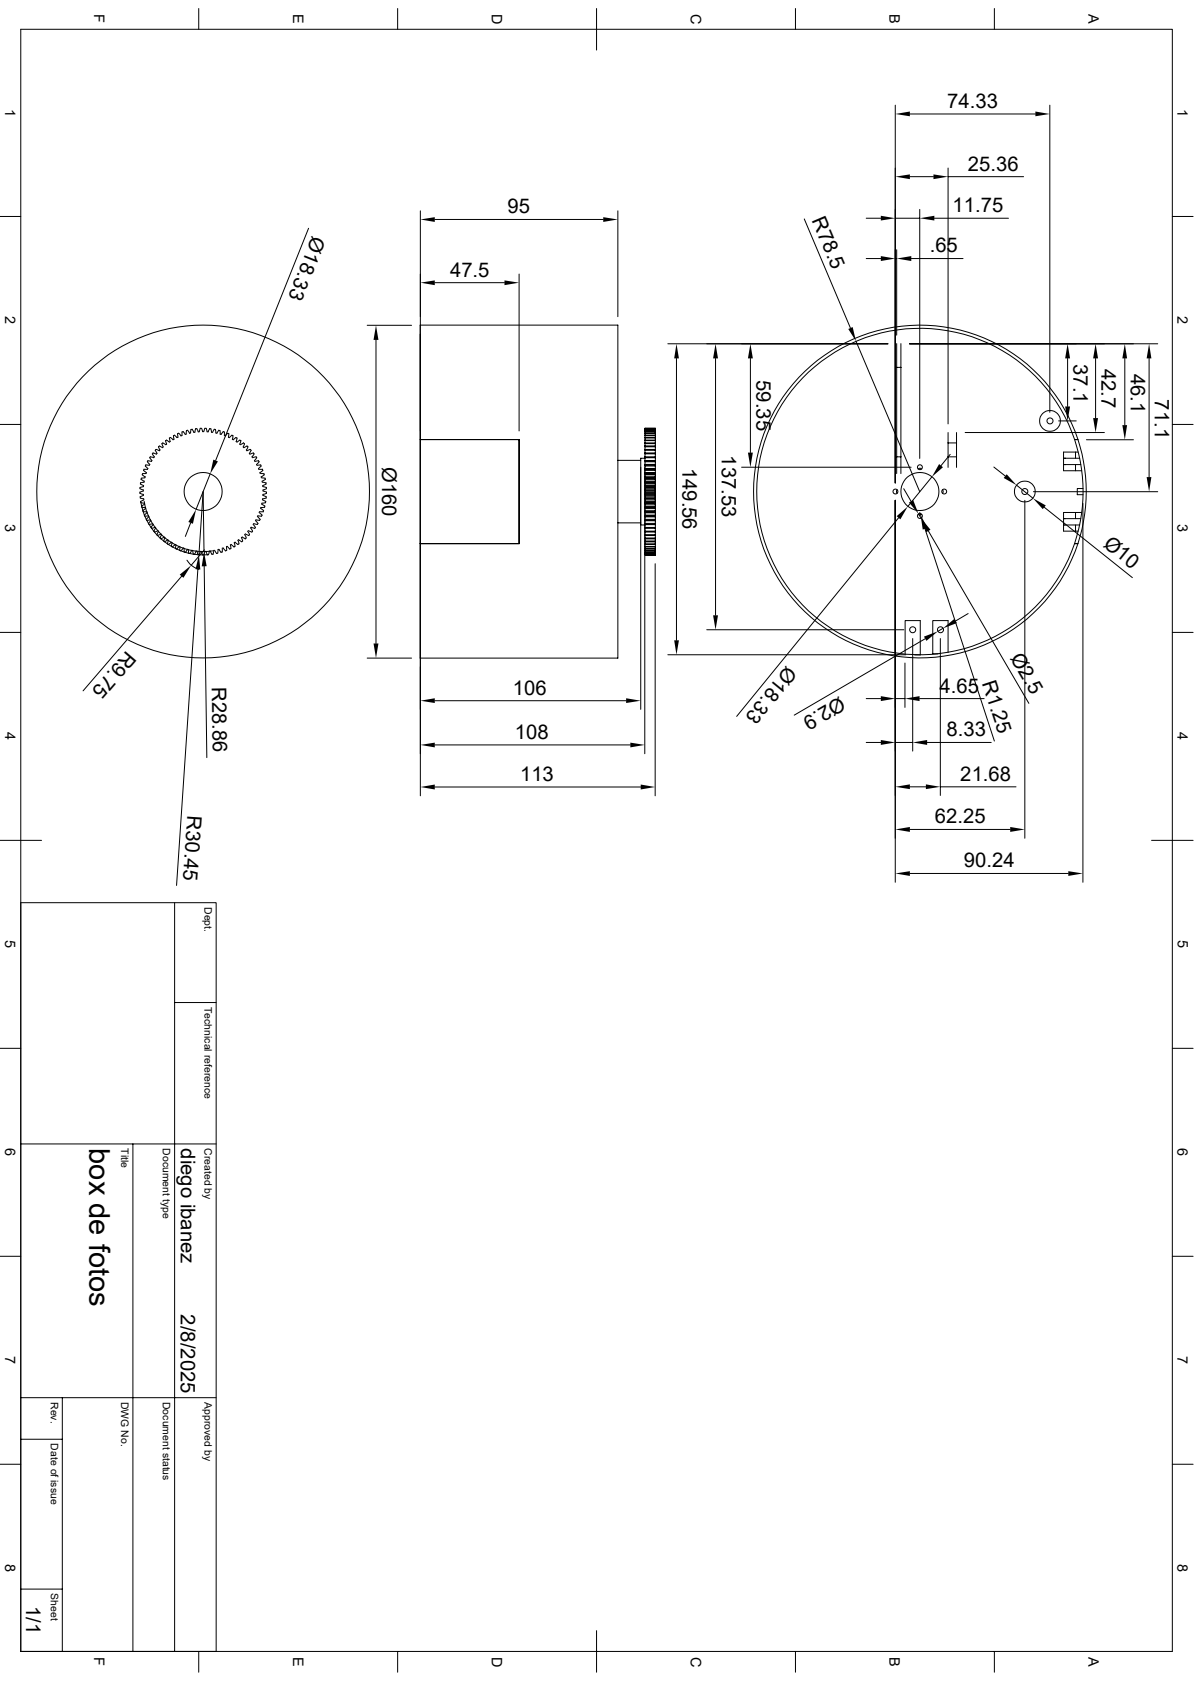
[picture p35: page 1]

1 A 2 3 4 5 6 7 8 1 2 3 4 5 6 7 8 FEDCB FEDCBA Dept. Technical reference Created by Approved by Title DWG No. Document type Document status Rev. Date of issue Sheet 2/8/2025 1/1 box de fotos diego ibanez Ø160
