ibanez-diego/proyecto-mecatronica-ibanez/Documentacion/planos mecanicos/soporte_exterior.pdf

10.33 69.73 76.75 69.73 48.69 21.06

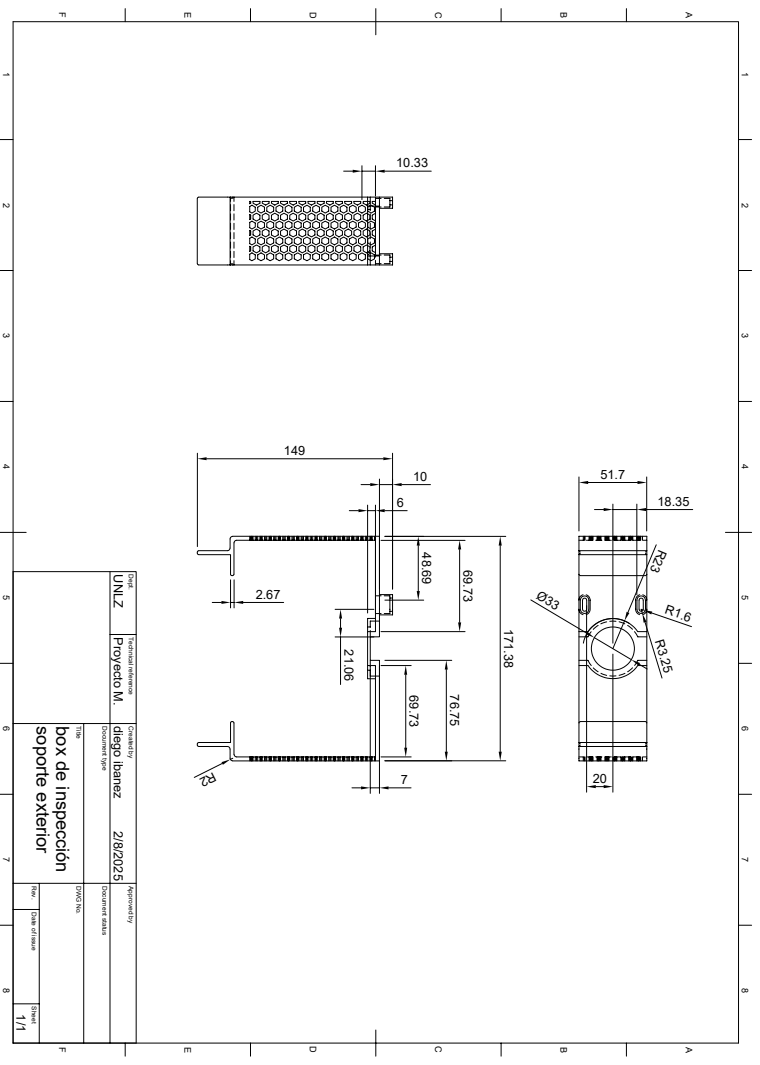
[picture p36: page 1]

1 A 2 3 4 5 6 7 8 1 2 3 4 5 6 7 8 FEDCB FEDCBA Dept. Technical reference Created by Approved by Title DWG No. Document type Document status Rev. Date of issue Sheet 2/8/2025 1/1 soporte exterior box de inspección diego ibanez Proyecto M. UNLZ 171.38
