ibanez-diego/proyecto-mecatronica-ibanez/Documentacion/planos mecanicos/box_de_inspección.pdf

94.24 | 93.69 90° | Ø18.33 | Ø160 | R1.6 | R4.25 R24 R2 | R46 | R45R47.4 R48.9 R43.5 R8 Ø2.9 Ø5 Ø14.42 | R1.58 | Ø12.42 R1.5 Ø3

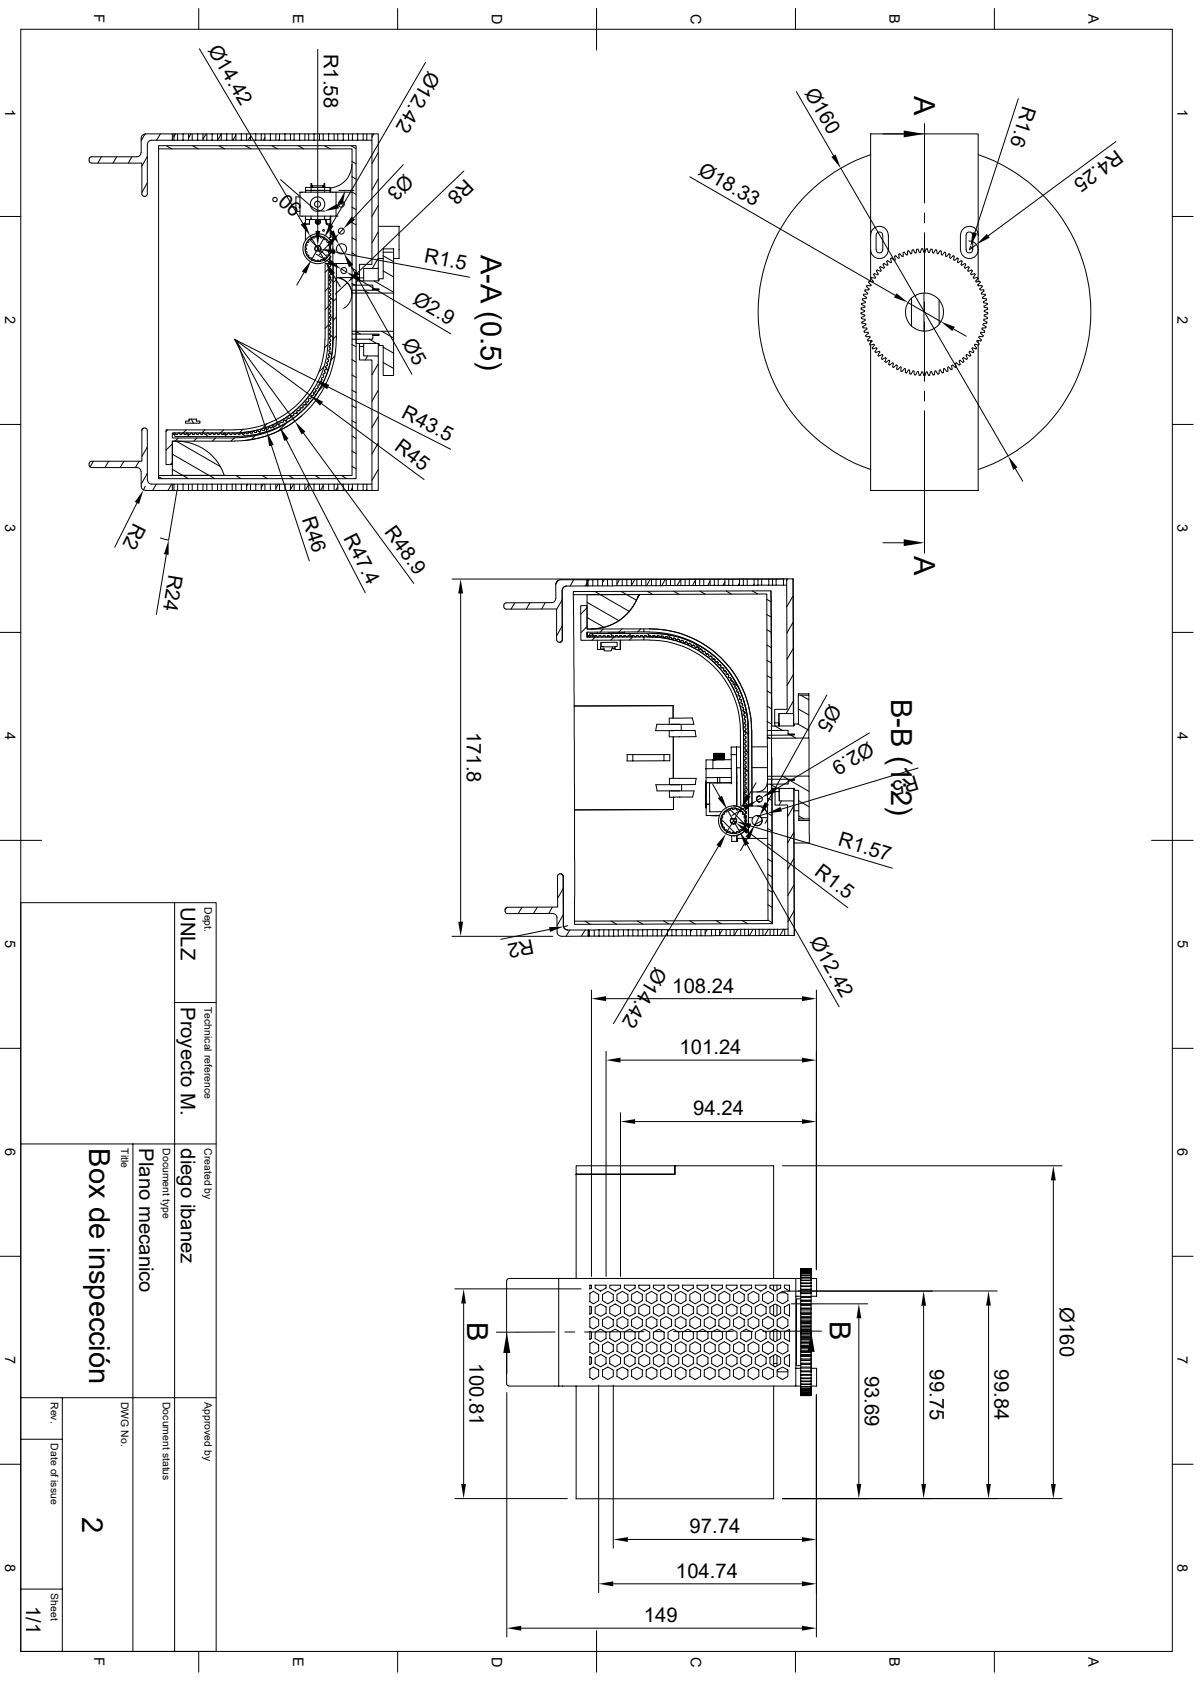
[picture p37: page 1]
149 ¹⁷¹.8

1 A 2 3 4 5 6 7 8 1 2 3 4 5 6 7 8 FEDCB FEDCBA Dept. Technical reference Created by Approved by Title DWG No. Document type Document status Rev. Date of issue Sheet Plano mecanico 1/1 2 Box de inspección diego ibanez Proyecto M. UNLZ A A A-A (0.5) BB B-B (1:2) Ø160
